LeoZ24/MAGNUS_Chess_Robot/README.md

# MAGNUS — Robot de Ajedrez Autónomo

> Proyecto de feria científica (PRONAFECYT 2026) construido por un estudiante de 16 años.
> Un robot que detecta el estado del tablero con visión artificial, calcula la mejor
> jugada con un motor de ajedrez y la ejecuta físicamente con un brazo articulado.

---

## Índice

1. [Arquitectura del sistema](#arquitectura-del-sistema)
2. [Hardware](#hardware)
3. [Software — módulos](#software--módulos)
4. [Especificaciones físicas críticas](#especificaciones-físicas-críticas)
5. [Estrategia de movimiento del brazo](#estrategia-de-movimiento-del-brazo)
6. [Sistema de localización con ArUco](#sistema-de-localización-con-aruco)
7. [Voz y comentarios](#voz-y-comentarios)
8. [Protocolo de mensajes entre módulos](#protocolo-de-mensajes-entre-módulos)
9. [Estado actual y hoja de ruta](#estado-actual-y-hoja-de-ruta)
10. [Instalación](#instalación)
11. [Ejecución rápida](#ejecución-rápida)
12. [Tests](#tests)
13. [Convenciones del proyecto](#convenciones-del-proyecto)

---

## Arquitectura del sistema

MAGNUS sigue una arquitectura modular inspirada en ROS2: nodos independientes que
se comunican mediante mensajes tipados. Cada nodo puede desarrollarse, testearse y
reemplazarse sin afectar a los demás.

```
┌─────────────────┐    PositionRequest(FEN)    ┌──────────────────┐    MoveResponse    ┌──────────────────────┐
│   NODO VISIÓN   │ ──────────────────────────▶│  NODO DEL ENGINE │ ──────────────────▶│  NODO DEL BRAZO      │
│  (ArUco/OpenCV) │                            │  (Stockfish/UCI) │                    │  (CyberPi / mBot2)   │
│                 │                            │                  │                    │                      │
│  Tablero físico │                            │  Calcula jugada  │                    │  Busca movimiento    │
│  → FEN string   │                            │  + metadatos     │                    │  pregrabado y lo     │
│                 │                            │                  │                    │  reproduce           │
└─────────────────┘                            └──────────────────┘                    └──────────────────────┘
       ▲                                                                                          │
  Cámara cenital                                                                          (V2 futuro) ▼
  (MacBook Air M1 /                                                                      Corrección por visión
   Raspberry Pi 4/5)                                                                      del marcador del brazo
```

### Módulos y estado

| Módulo | Ruta | Estado | Descripción |
|---|---|---|---|
| **Mensajes/Core** | `magnus/core/` | ✅ Completo | Contratos de datos entre nodos (PositionRequest, MoveResponse) |
| **Engine** | `magnus/engine/` | ✅ Completo | FEN → jugada con metadatos, via Stockfish UCI |
| **Visión** | `magnus/vision/` | ✅ Software completo | Detección → homografía → FEN exacta (turno/enroque por inferencia); falta validar con cámara/tablero reales |
| **Brazo robótico**| `magnus/arm/` | 🔶 En pruebas reales | Secuencias pregrabadas + `CyberPiBackend` (TCP sobre Wi-Fi) funcionando con el brazo real y tabla `positions.json` grabada; falta afinar la precisión |
| **Voz** | `magnus/voice/` | ✅ Software completo | El robot narra sus jugadas y comenta las del rival en español; falta elegir la voz definitiva de oído |
| **App de juego**  | `magnus/app/` + `play.py` | ✅ Completo | Une los cuatro nodos en una aplicación con panel de control web: partida en vivo, dificultad en caliente, ajustes y brazo (apagado / simulado / CyberPi) |

---

## Hardware

### Computación

| Dispositivo | Rol | Estado |
|---|---|---|
| MacBook Air M1 | Desarrollo y procesamiento visual | En uso |
| Raspberry Pi 4 o 5 | Computación embebida (producción) | Futuro |
| CyberPi (placa mBot2) | Control de motores/servos del brazo | En uso (TCP sobre Wi-Fi) |

### Cámara

- Montaje cenital (mirando hacia abajo sobre el tablero)
- Calibración de cámara **pendiente** (necesaria para la homografía de las
  esquinas del tablero y el rastreo del marcador del brazo)
- Se usa con OpenCV y el módulo `cv2.aruco`

### Tablero de ajedrez

- **Tamaño de casilla:** 32 mm × 32 mm
- **Área de juego total:** 256 mm × 256 mm (8×8 casillas)
- **Imanes en casillas:** cilíndrico 6×3 mm, uno por casilla, embutido en el
  centro — mantienen las piezas posicionadas
- **Marcadores ArUco en las 4 esquinas del tablero** (nuevo): permiten calcular
  la homografía tablero↔cámara, necesaria para la futura corrección de
  posición del brazo (ver [Sistema de localización con ArUco](#sistema-de-localización-con-aruco))
- Material: accesible / imprimible en 3D

### Piezas de ajedrez

- **Forma:** circular (tapa plana)
- **Diámetro:** 22.5 mm
- **Marcador ArUco:** integrado en la cara superior (diccionario `DICT_4X4_50`)
- **Anillo de contraste:** blanco, alrededor del marcador, para mejorar detección
- **Imán en pieza:** cilíndrico 10×2 mm, embutido en la base
- **Fabricación:** filamento PLA en BambuLab A1 mini

#### Asignación de IDs ArUco

Hay **tres roles distintos** de marcadores ArUco con rangos de ID separados,
definidos formalmente en `magnus/config.py`:

| Rol | Cantidad | IDs | Estado |
|---|---|---|---|
| Piezas de ajedrez | 12 tipos (32 piezas físicas) | `0–23` (con huecos) | ✅ mapeo oficial en `magnus/vision/piece_map.py` |
| Esquinas del tablero | 4 | `40–43` | ✅ 40=a8, 41=h8, 42=h1, 43=a1 |
| Marcador del brazo | 1 | `44` | ✅ reservado (rastreo V2) |

> **Mapeo ID→pieza oficial:** el marcador identifica el **tipo** de pieza
> (tipo + color), no la pieza individual — todos los peones blancos llevan el
> mismo marcador. La detección rastrea las instancias repetidas por posición.
>
> | Pieza   | Blancas | Negras | | Pieza | Blancas | Negras |
> |---------|---------|--------|-|-------|---------|--------|
> | Peón    | `0`     | `12`   | | Torre | `6`     | `18`   |
> | Caballo | `1`     | `15`   | | Dama  | `8`     | `21`   |
> | Alfil   | `2`     | `16`   | | Rey   | `9`     | `23`   |
>
> Los PNG imprimibles de los 17 marcadores (cada etiqueta indica cuántas copias
> imprimir) se generan con `python3 examples/generate_aruco_markers.py`.

### Brazo robótico — articulado, 2 grados de libertad + garra

| Actuador  | Articulación | Puerto | Función |
|---|---|---|---|
| Motor 1 | Hombro | `EM1`  | Primer eslabón (motor Encoder mBot2, transmisión directa) |
| Motor 2 | Codo | `EM2`  | Segundo eslabón (motor Encoder mBot2, transmisión directa) |
| Servo 3 | Garra/agarre | `S1` | Baja, levanta y suelta el imán N52 sobre la pieza |

- **Control:** CyberPi (placa del kit mBot2) con el cliente
  `examples/cyberpi_arm_client.py`, subido desde mBlock en modo UPLOAD
- **Sin reductores:** grado de motor = grado de eslabón en los dos ejes (se
  probó un 3:1 en el hombro y se descartó)
- **Sistema de agarre (confirmado):** imán N52 (12×3 mm) en el extremo del
  brazo. El servo `S1` tiene **tres posiciones**: `0°` baja el imán y agarra la
  pieza, `110°` la **levanta sin soltarla** (para no arrastrarla por el tablero)
  y `170°` la suelta. Hombro y codo no dan altura: la da este servo
- **Apoyo del hombro:** un geekservo en `M1` puede empujar a favor del hombro
  (`ASSIST_ENABLED`, desactivado por defecto)
- **Fabricación de partes estructurales:** PLA en BambuLab A1 mini
- **Comunicación Python ↔ CyberPi (confirmada):** TCP sobre Wi-Fi. El ordenador
  abre un servidor (`CyberPiBackend`, puerto 5555) y la CyberPi se conecta a él.
  Protocolo de líneas de texto: `PING` / `HOME` / `LIMITS` / `ZERO` / `MOVE` /
  `GRIPPER` / `GET` / `STOP`, cada una con su `ACK` o `ERR <mensaje>`
- **Referenciado (`HOME`):** los encoders son incrementales, así que al
  conectar cada eje se empuja contra un tope físico y se declara el cero ahí
  (primero el codo, luego el hombro). Por eso el hombro solo admite ángulos
  **positivos** y el codo solo **negativos**

> ⚠️ El cliente lleva `SSID` / `PASS` / `MAC_IP` como **marcadores**: los datos
> reales del Wi-Fi se escriben solo en mBlock antes de subirlo a la placa y
> nunca se copian al repositorio.

⚠️ **Cuidado con el imán N52:** es fuerte y su radio de influencia puede
desplazar piezas en casillas adyacentes si el brazo pasa muy cerca del tablero
en movimientos laterales. Ver [Estrategia de movimiento del brazo](#estrategia-de-movimiento-del-brazo).

---

## Software — módulos

### `magnus/core/` — Contratos de datos

Estructuras de datos puras sin dependencias de ajedrez. Cualquier nodo puede
importarlas sin arrastrar `python-chess`.

```python
# Petición al engine
PositionRequest(
    fen="rnbqkbnr/pppppppp/8/8/8/8/PPPPPPPP/RNBQKBNR w KQkq - 0 1",
    difficulty="MEDIUM",  # o None para usar la dificultad por defecto del nodo
    movetime=None,        # segundos máximos de cálculo (None = usar preset)
    request_id="move-001"
)

# Respuesta del engine (incluye metadatos para el brazo)
MoveResponse(
    uci="e2e4",           # origen→destino para el brazo
    san="e4",             # notación algebraica
    is_capture=False,
    captured_square=None, # casilla donde está la pieza capturada (≠ to_square en al paso)
    is_castling=False,
    rook_from=None,       # para enroque: el brazo debe mover también la torre
    rook_to=None,
    is_en_passant=False,  # captura al paso: la pieza capturada NO está en to_square
    promotion=None,       # "q", "r", "b", "n"
    is_check=False,
    is_checkmate=False,
    resulting_fen="...",  # FEN tras la jugada (para verificación con visión)
    ...
)
```

### `magnus/engine/` — Nodo del engine

Recibe una `PositionRequest` (FEN + dificultad), usa Stockfish via protocolo UCI
y devuelve una `MoveResponse` con todos los metadatos relevantes para el brazo.

**Niveles de dificultad (10):**

| Nivel | Elo aprox. | `movetime` | Cómo se debilita |
|---|---|---|---|
| `LEARNER`  | ~400 | 0.05 s | errores a propósito (85 %) |
| `NOVICE` | ~700 | 0.05 s | errores a propósito (70 %, pierde ≤ 900 cp) |
| `CASUAL` | ~950 | 0.05 s | errores a propósito (55 %, pierde ≤ 600 cp) |
| `AMATEUR`  | ~1150 | 0.05 s | errores a propósito (50 %, pierde ≤ 450 cp) |
| `BEGINNER` | ~1350 | 0.05 s | `Skill Level` 0 + `UCI_Elo` |
| `EASY` | ~1500 | 0.10 s | `Skill Level` 3 + `UCI_Elo` |
| `MEDIUM` | ~1800 | 0.20 s | `Skill Level` 8 + `UCI_Elo` (por defecto) |
| `HARD` | ~2200 | 0.50 s | `Skill Level` 14 + `UCI_Elo` |
| `EXPERT` | ~2600 | 1.00 s | `Skill Level` 18 + `UCI_Elo` |
| `MAXIMUM`  | máximo | 2.00 s | sin límite |

Stockfish no baja de ~1320 de Elo, así que los cuatro niveles más bajos se
debilitan **por software**: el backend pide varias jugadas candidatas
(`multipv`) y, con cierta probabilidad, elige una peor que la mejor sin perder
más de un tope de centipeones. En esos niveles el Elo es una etiqueta
aproximada. Los presets están en `magnus/engine/difficulty.py`.

El backend es intercambiable: cualquier motor UCI (Stockfish, Lc0, Komodo...)
funciona sin cambiar el resto del sistema.

### `magnus/vision/` — Nodo de visión

Tablero físico → placement → FEN exacta. Componentes:

- `aruco_detector.py` — detección con "enclavamiento" **multi-instancia**: un
  marcador debe verse N frames consecutivos antes de confirmarse, y como los
  IDs identifican el *tipo* de pieza (los 8 peones blancos comparten ID), cada
  instancia física se rastrea por posición; los tres roles de marcadores van
  separados.  Las esquinas, al ser estáticas y de ID único, **se recuerdan en
  su última posición** aunque una pieza las tape
- `board_pose.py` — homografía tablero(mm)↔imagen(px) con las 4 esquinas; mapea
  el centro de cada pieza a su casilla.  Deduce de la geometría qué esquina
  ocupa cada marcador (tolera marcadores cruzados y cualquier orientación de
  cámara) y descarta lo que esté fuera del área de juego
- `piece_map.py` — mapeo oficial ID ArUco → símbolo FEN (por tipo de pieza)
- `fen_builder.py` — placement → texto FEN (módulo puro)
- `game_state.py` — `GameTracker`: deduce la jugada del humano comparando el
  placement detectado contra las jugadas legales de la partida → turno,
  enroque y al paso exactos, sin hardware extra
- `calibration.py` — calibración de cámara (opcional en v1)
- `synthetic.py` — genera imágenes sintéticas del tablero (tests/demos sin cámara)
- `board_render.py` — representación 2D profesional del tablero (iconos de
  pieza, última jugada, flecha de la jugada planificada, jaque) + dashboard
  completo para el demo en vivo
- `vision_node.py` — `BoardVisionNode` con backend de cámara intercambiable
  (`OpenCVCameraBackend` real / `FakeCameraBackend` para tests)

```python
from magnus.vision import BoardVisionNode, OpenCVCameraBackend

with BoardVisionNode(camera=OpenCVCameraBackend(0)) as node:
    placement = node.get_board_placement()   # {"e4": "P", ...}
    fen = node.get_board_fen()               # FEN exacta tras la jugada del humano
```

**Pendiente:** validar con la cámara y el tablero físicos reales; rastreo del
marcador del brazo (V2).

### `magnus/arm/` — Nodo del brazo

Recibe una `MoveResponse` y reproduce los movimientos **pregrabados**
correspondientes. No calcula cinemática inversa.

- `backend.py` — `ArmBackend` (ABC) + `FakeArmBackend` (tests/demos, registra
  los comandos) + `CyberPiBackend` (servidor TCP al que se conecta la CyberPi;
  repite hasta 2 veces un `MOVE` que la placa rechaza con `ERR`)
- `positions_table.py` — carga/consulta de `positions.json` (64 casillas +
  zonas `discard`/`exchange` + reposo `park` opcional) e
  `inspect_positions_file()`, que dice sin lanzar excepciones si la tabla está
  completa
- `arm_node.py` — `ArmNode.plan()` genera la secuencia (testeable) y
  `.execute()` la reproduce:
  - Si `is_capture`: mueve primero la pieza capturada a la zona de descarte
  - Si `is_castling`: rey primero, luego torre (`rook_from`/`rook_to`)
  - Si `is_en_passant`: retira el peón de `captured_square` (≠ destino)
  - Si `promotion`: peón a descarte + pieza promovida desde la zona de intercambio
  - Activa/desactiva la garra (servo 3) en los momentos correctos
  - Al terminar, retira el brazo a `park` para no tapar el tablero a la cámara
  - Fuera del tablero (`discard`, `park`) pide menos precisión
    (`config.ARM_OFFBOARD_TOLERANCE_DEG`) para no perder tiempo afinando

```python
from magnus.arm import ArmNode, FakeArmBackend, make_fake_table

with ArmNode(backend=FakeArmBackend(), table=make_fake_table()) as arm:
    steps = arm.execute(resp)   # resp: MoveResponse del engine
```

**Pendiente:** medir el recorrido real de cada eje (`SHOULDER_TRAVEL_DEG` /
`ELBOW_TRAVEL_DEG`, ahora 300° provisionales) y comprobar `BACKLASH_DEG`.

---

## Especificaciones físicas críticas

Estas constantes son fundamentales para todos los módulos. Están centralizadas
en **`magnus/config.py`** (única fuente de verdad — no hardcodearlas en módulos).

```python
# Tablero
SQUARE_SIZE_MM       = 32.0    # lado de cada casilla en mm
BOARD_SQUARES        = 8       # 8×8
BOARD_SIZE_MM        = SQUARE_SIZE_MM * BOARD_SQUARES  # 256 mm

# Piezas
PIECE_DIAMETER_MM    = 22.5
PIECE_MAGNET_D_MM    = 10.0    # diámetro imán pieza
PIECE_MAGNET_H_MM    = 2.0     # altura imán pieza

# Tablero — imanes de casilla
SQUARE_MAGNET_D_MM   = 6.0
SQUARE_MAGNET_H_MM   = 3.0

# Brazo — imán de agarre
ARM_MAGNET_D_MM      = 12.0
ARM_MAGNET_H_MM      = 3.0
ARM_MAGNET_GRADE     = "N52"   # fuerte: puede influir en piezas adyacentes

# ArUco — rangos de ID por rol (oficiales)
ARUCO_DICT           = "DICT_4X4_50"
ARUCO_IDS_PIECES      = frozenset({0, 1, 2, 6, 8, 9, 12, 15, 16, 18, 21, 23})
                                       # 12 tipos de pieza (las copias comparten ID)
ARUCO_IDS_BOARD_CORNERS = (40, 41, 42, 43)  # esquinas del tablero
ARUCO_ID_ARM          = 44             # marcador en el extremo del brazo
DETECTION_CONFIRM_N   = 5              # detecciones consecutivas para confirmar presencia
DETECTION_MATCH_RADIUS_FACTOR = 1.5    # asociación espacial de IDs repetidos
DETECTION_FORGET_FRAMES = 20           # olvidar una pieza confirmada que ya no se ve
```

---

## Estrategia de movimiento del brazo

> Esta es la decisión de diseño más importante del proyecto: MAGNUS **no**
> calcula cinemática inversa en tiempo real. En su lugar usa un enfoque de
> **"enseñar y reproducir" (teach & playback)**.

### ¿Por qué no cinemática inversa?

Con solo 64 casillas fijas, no es necesario resolver la trigonometría de un
brazo de 2 eslabones en cada jugada. Es más simple, más confiable para una
primera versión, y suficiente para una feria científica:

1. **Una sola vez**, se determinan y registran los ángulos de hombro y codo
   necesarios para que el brazo llegue al centro de cada una de las 64 casillas
2. Esos valores se guardan en una **tabla de consulta** (lookup table)
3. Durante el juego, el nodo del brazo simplemente **busca** los valores
   pregrabados para la casilla de origen y de destino, y reproduce esa
   secuencia de movimiento — sin ningún cálculo geométrico en vivo

### Formato de la tabla (`magnus/arm/positions.json`)

Una posición de hombro y codo por casilla, en grados de motor desde `HOME`.
El brazo no tiene movimiento vertical: el servo **S1** recoge y suelta usando
los mismos dos ángulos para todas las piezas.

La plantilla vacía (`python3 examples/generate_positions_template.py`) usa:

```json
{
  "e4": {"shoulder": null, "elbow": null},
  "e5": {"shoulder": null, "elbow": null}
}
```

Sustituye los `null` por lecturas reales. Las tablas antiguas con
`approach`/`engage` siguen cargando; se usa **`engage`** como posición única.

Además de las 64 casillas, la tabla lleva las zonas `discard` (piezas
capturadas) y `exchange` (piezas de promoción), y opcionalmente **`park`**: una
pose de reposo **fuera del tablero** a la que el brazo se retira al terminar
cada jugada, para no estorbar al rival ni taparle el tablero a la cámara. Sin
`park` se juega igual, solo que el brazo se queda donde terminó.

Una jugada típica (`e2` → `e4`, sin captura):

```
mover a e2 → S1 agarra y levanta → mover a e4 → S1 suelta → mover a park
```

### Cómo grabar la tabla

Con el cliente en la CyberPi y `play.py` cerrado, el modo recomendado es
**`--jog`**: el brazo se mueve con sus propios motores y tú lo ajustas a pasos
hasta que la punta cae en la casilla. Se graba la **orden**, no la lectura del
encoder:

```bash
python3 examples/record_arm_positions.py --all --jog --write   # toda la tabla
python3 examples/record_arm_positions.py e4 d5 --jog --write   # solo algunas
python3 examples/record_arm_positions.py park --jog --write    # zona de reposo
```

> **Por qué no colocarlo a mano.** Con los motores sueltos el brazo no flexa
> igual que cuando lo empujan los motores: el mismo ángulo de encoder deja la
> punta en dos sitios distintos. Una tabla medida a mano se queda corta siempre
> en el mismo sentido y sin dar ningún error.

Teclas del modo `--jog`:

| Tecla | Qué hace |
|---|---|
| `h+5`, `c-3`, `h+2 c-1` | ajusta hombro / codo a pasos |
| `h=85` | fija un valor exacto |
| `Enter` | graba la casilla y pasa a la siguiente |
| `p` | prueba a recoger la pieza (agarra y levanta; `Enter` la suelta) |
| `v` | lleva el brazo a la orden desde lejos y por los dos lados, como al jugar |
| `r` | hace `HOME` otra vez (`--home-each` lo hace antes de cada destino) |
| `s` / `q` | salta la casilla / sale |

`--write` **fusiona** lo grabado en `magnus/arm/positions.json` (dejando una
copia `.bak`): grabar dos casillas no borra las demás. Sin `--write` solo
imprime el JSON. No apagues el shield ni reinicies la CyberPi entre lecturas:
perderías el cero.

Los tres ángulos de la garra (`GRIPPER_ENGAGE_ANGLE`, `GRIPPER_LIFT_ANGLE`,
`GRIPPER_RELEASE_ANGLE`) son comunes a todas las piezas y viven en el cliente
de la CyberPi; no se graban por casilla.

### Cómo se mueve cada eje (cliente CyberPi)

El control interno del motor encoder es de **velocidad**, no de par: a pocas
RPM no vence el peso del brazo. Por eso cada `MOVE` tiene dos fases:

1. **Tramo grueso** con `EM_turn`; si una pasada se queda corta, la siguiente
   va más rápida (más RPM = más par).
2. **Último tramo** con impulsos de potencia cruda que miden el ritmo real del
   eje y se acortan al acercarse, para llegar sin pasarse.

Otras defensas, todas en `examples/cyberpi_arm_client.py`:

- **Retención nativa** (`EM_lock`, `HOLD_ENABLED`): los ejes se sostienen
  entre movimientos. `STOP`, un fallo o una desconexión **liberan los
  motores**: sostén el brazo con la mano al pararlo.
- **El codo se mueve primero y el hombro al final**, porque el hombro es el
  que peor se sostiene. Al terminar se releen los dos encoders y se corrige el
  que haya cedido.
- **Compensación de juego** (`BACKLASH_DEG`, 3°): el último tramo entra
  siempre en el mismo sentido, así la tabla grabada a pasos cortos y la
  partida con giros largos llegan igual.
- **Presupuesto de tiempo:** un `MOVE` deja de afinar a los 15 s y responde
  con lo que haya; si lo rechaza, el ordenador lo repite (es absoluto, así que
  repetirlo lleva al mismo sitio).

**Cada cambio del cliente hay que volver a subirlo desde mBlock en modo
UPLOAD**: reiniciar `play.py` no actualiza la placa. Si aparece `EM_lock no
disponible`, actualiza el firmware de CyberPi/mBot2. Si la subida se queda
colgada en 1 %, para el programa en marcha, cierra el monitor serie, reinicia
la placa o prueba otro cable USB.

Con `play.py` cerrado y el espacio del brazo despejado, `python3 test_humo.py`
mide el error de cada eje, la deriva en reposo y el retorno a cero, e imprime
un diagnóstico. Si el brazo se queda corto, la causa número uno es la batería
del shield (los motores **no** se alimentan del USB).

### Corrección automática de posición (V2 — futuro, no implementar todavía)

Si los movimientos pregrabados resultan imprecisos (por ejemplo, por
deslizamiento mecánico o desgaste), el plan a futuro es:

1. Calcular la posición **esperada** del marcador del brazo en la imagen
   (usando la homografía de las 4 esquinas del tablero + la casilla objetivo)
2. Detectar la posición **real** del marcador del brazo con la cámara
3. Calcular el **offset** (error) entre la posición esperada y la real
4. Ajustar levemente los ángulos de motor antes de ejecutar el siguiente movimiento

Este flujo de corrección **no es parte de la v1** del proyecto, pero el
sistema de marcadores ArUco (esquinas + marcador del brazo) se está
incorporando desde ahora para tenerlo listo cuando se necesite.

---

## Sistema de localización con ArUco

Tres roles de marcadores, cada uno con su propio propósito:

| Marcador | Cantidad | Propósito |
|---|---|---|
| En cada pieza | 12–32 | Identificar tipo/color de pieza → construir la FEN |
| En las 4 esquinas del tablero | 4 | Calcular la homografía tablero↔cámara (pose del tablero) |
| En el extremo del brazo | 1 | Rastrear la posición real del brazo (para corrección V2) |

La homografía de las esquinas permite, en teoría, ubicar cualquier punto del
tablero en coordenadas de imagen y viceversa — esto es lo que hace posible,
a futuro, comparar "dónde debería estar el brazo" contra "dónde está
realmente" usando la cámara.

### Cómo colocar los 4 marcadores de esquina

Los IDs **recorren el borde del tablero**, no van en orden de lectura:

```
    40 (a8) ─────────── 41 (h8)          ✅ 40 → 41 → 42 → 43 recorre el
      │                    │                borde (sentido horario visto
    43 (a1) ─────────── 42 (h1)             desde arriba con blancas abajo)

    40 ─────── 41                        ❌ zig-zag: 42 y 43 cruzados
      │  ╳     │
    42 ─────── 43
```

El centro de cada marcador debe coincidir con la esquina exterior del área de
juego.  Puntos importantes del montaje:

- **La orientación de la cámara da igual**: cada esquina se identifica por su
  ID, así que la cámara puede estar apaisada, vertical, del lado de las blancas
  o de las negras, y el tablero girado cualquier ángulo dentro de la imagen.
- Si dos marcadores contiguos se colocan cruzados, la visión lo **detecta y lo
  corrige sola** (avisa en el dashboard) — antes esto producía una homografía
  degenerada en la que todas las piezas caían "fuera del tablero".
- Si el tablero digital sale girado 90/180°, se corrige con la tecla `T` del
  demo, o iniciando la partida con `G` desde la posición inicial (deduce la
  orientación probando los cuatro giros).
- Una esquina tapada por una pieza **no** rompe nada: la última posición
  conocida se recuerda mientras la cámara y el tablero no se muevan (tecla `R`
  para olvidarla si se mueven).

---

## Voz y comentarios

MAGNUS narra lo que hace y comenta cómo va la partida, en español:

> «Muevo el caballo de ge uno a efe tres.»
> «Capturo el peón en e cinco con el alfil desde ce cuatro. Jaque.»
> «Uy. Eso fue un error grave.» · «Buena jugada. Sigue así.»

### Cómo decide qué comentar

Se compara la evaluación **antes y después** de la jugada del rival, igual que
hacen Lichess o Chess.com:

```
Δ = eval_después − eval_antes        (siempre a favor del robot, en centipeones)

Δ ≥ +300  error grave      Δ ≤  −50  buena jugada
Δ ≥ +150  error            Δ ≤ −150  muy buena jugada
Δ ≥  +50  imprecisión      |Δ| < 50  normal → se calla
```

Los umbrales están en `magnus/config.py` (`COMMENT_*`) y son generosos a
propósito: es preferible callar que acusar de un error que no lo fue.

El análisis usa `ChessEngineNode.analyse_fen()`, que va a **fuerza fija**
(`ANALYSIS_CONFIG`, skill 20) y no a la dificultad de juego. Así el robot puede
jugar en `BEGINNER` para que le ganes y aun así **comentar como un maestro**.

### Motor de voz

| Backend | Cuándo | Notas |
|---|---|---|
| `PiperBackend` | **Recomendado** | Neuronal, local, gratis. Sin internet y con el mismo código en Mac y Raspberry Pi |
| `MacSayBackend` | Respaldo | El comando `say` de macOS, cero instalación |
| `FakeSpeechBackend` | Tests y silencio | No suena; registra lo que se habría dicho |

`default_backend()` elige el mejor disponible y, si no hay ninguno, devuelve el
falso: **quedarse sin voz nunca interrumpe una partida**.

> **En macOS el intérprete se llama `python3`, no `python`** (`python` a secas
> da `zsh: command not found`). Y si tienes varias versiones instaladas, usa
> siempre `python3.X -m pip install …` en vez de `pip install …`: así el paquete
> acaba en el mismo intérprete con el que ejecutas el proyecto. Ese desajuste es
> la causa número uno del `No module named 'piper'`.

```bash
# Comprueba con qué Python estás trabajando y que ahí está piper
python3 -c "import sys, piper; print(sys.executable, 'piper OK')"

# Voces del sistema (macOS): no hay que instalar nada
python3 examples/audition_voices.py --engine say        # audiciona las masculinas
python3 examples/audition_voices.py --engine say --all-spanish --list

# Piper (para la Raspberry Pi). OJO: instálalo en el MISMO Python con el que
# ejecutas el proyecto — tener varios Python es la causa nº 1 de
# "No module named 'piper'":
python3 -m pip install piper-tts          # OJO: python3 -m pip, no pip
python3 -m piper.download_voices es_MX-claude-high --data-dir voices/
python3 examples/audition_voices.py --engine piper --play
```

> **Los modelos de voz NO se suben a git.** Pesan entre 60 y 110 MB y GitHub
> rechaza cualquier archivo de más de 100 MB (`GH001: Large files detected`).
> La carpeta `voices/` está en `.gitignore`: cada quien descarga la voz que
> necesita. Si por accidente ya los commiteaste, sácalos con
> `git rm -r --cached voices` antes de volver a hacer push.
>
> **El sufijo del nombre es el nivel de calidad y se nota muchísimo.**
> `x_low` y `low` van a 16 kHz y suenan apagadas, "como debajo del agua";
> `medium` sube a 22 kHz; `high` es la única que suena natural. Usa siempre una
> voz `-high`. MAGNUS **no aplica ningún efecto de audio** a la voz (ni
> filtros, ni cambio de tono, ni resampleo): si suena rara, es el modelo.

La voz elegida se pone en `magnus/config.py` → `VOICE_MACOS_VOICE` (para `say`)
o `VOICE_PIPER_MODEL` (para Piper). También se puede probar sin editar nada:
`python3 examples/run_vision_demo.py --say-voice Jorge`.

MAGNUS habla en masculino, así que la voz por defecto de macOS es **Juan**
(es_MX); si no está instalada, el backend busca otra voz masculina en español
en vez de quedarse mudo.

### Qué más dice

Además de narrar y evaluar, el robot avisa cuando el tablero no cuadra, y
distingue **qué** está pasando en vez de soltar un genérico "no entiendo".
`VOICE_WARN_BOARD_PROBLEMS` elige de cuáles de estos avisa en voz alta:

| Situación detectada | Qué dice | ¿Por defecto? |
|---|---|---|
| Una pieza cambió de casilla pero la jugada no es legal | «Esa jugada no es legal. Devuelve la pieza a su sitio.» | ✅ sí |
| Falta una pieza, no hay ninguna nueva | «¿Tienes una pieza en la mano? Colócala cuando decidas.» | ❌ no |
| Demasiadas diferencias (mano encima, piezas caídas) | «Algo no cuadra en el tablero. Revísalo, por favor.» | ❌ no |
| El tablero vuelve a ser correcto | «Ahora sí. Seguimos.» | tras un aviso |

**Por qué solo la jugada ilegal.** Los otros dos avisos se apoyan en que una
pieza *desaparezca* del tablero, y con poca luz la detección parpadea: las
piezas se pierden un par de segundos y vuelven, así que saltaban en falso todo
el rato. Una jugada ilegal exige que la pieza reaparezca en **otra** casilla,
cosa que el parpadeo no produce — por eso este aviso sí aguanta con mala luz. Y
además es el único que le dice al rival algo que no sabe ya.

Los problemas silenciados tampoco disparan el «ahora sí, seguimos»: sería raro
oír el visto bueno de algo de lo que nunca se avisó.

El aviso **no se repite** mientras el problema siga igual: durante una jugada
larga saldría en bucle. La clasificación vive en `commentary.diagnose_placement()`
y es una función pura sobre dos diccionarios de casillas, así que se testea sin
cámara ni tablero.

Puede narrar también las jugadas del rival (`VOICE_ANNOUNCE_HUMAN_MOVES`,
desactivado por defecto: repetir en voz alta lo que el rival acaba de hacer
delante de él resulta redundante). Con el flag en `False` el robot sigue
reaccionando a las capturas y a los jaques, que sí aportan.

En todo caso recuerda con amabilidad que le toca si tarda mucho
(`VOICE_IDLE_PROMPT_S`), saluda, dice «te toca» tras mover y despide la
partida. Cada situación tiene entre 3 y 7 formulaciones distintas y nunca
repite la última usada.

### Detalles que importan

- **Nunca se le pasa notación cruda al TTS**: `"g1"` se convierte en `"ge uno"`
  y `"N"` en `"caballo"` (`speech_text.py`). Un TTS leyendo "Cxf3" es
  ininteligible.
- **Se habla en un hilo aparte**: sintetizar tarda ~1 s y la visión corre a
  ~14 fps; hablar en el bucle principal la congelaría.
- **Subtítulos en el dashboard**: la última frase aparece sobre la imagen de la
  cámara. En una feria ruidosa se lee aunque no se oiga. Tecla `M` para
  silenciar el audio manteniendo los subtítulos.
- **La voz es accesoria**: si el audio falla, se registra el error y la partida
  continúa en silencio.

---

## Protocolo de mensajes entre módulos

Los módulos se comunican con objetos Python pasados directamente (mismo proceso)
o serializados a JSON (procesos separados / red).

```python
# Serialización
req_dict  = request.to_dict()           # -> dict JSON-serializable
req_again = PositionRequest.from_dict(req_dict)  # tolera claves extra

resp_dict = response.to_dict()          # MoveResponse también tiene to_dict()
```

---

## Estado actual y hoja de ruta

### ✅ Completado

- Contratos de datos entre módulos (`magnus/core/`)
- Nodo del engine completo con 10 niveles de dificultad (`magnus/engine/`),
  los cuatro más bajos con errores a propósito
- Backend UCI intercambiable (Stockfish por defecto)
- Constantes físicas centralizadas (`magnus/config.py`)
- Módulo de visión completo (`magnus/vision/`): detección con enclavamiento,
  homografía de esquinas, mapeo ID→pieza, construcción de FEN completa
- Detección del turno/enroque/al paso por inferencia (`GameTracker`)
- Módulo del brazo (`magnus/arm/`): tabla de posiciones + planificador y
  reproductor de secuencias (captura, al paso, enroque, promoción)
- Zona de piezas capturadas y de intercambio (lógica; falta la física)
- Integración de los tres nodos, demostrada sin hardware
  (`examples/run_full_pipeline_demo.py`)
- Aplicación de juego con panel de control web (`play.py` + `magnus/app/`):
  partida en vivo, dificultad en caliente, ajustes persistentes, brazo en modo
  apagado / simulado / CyberPi
- Voz en español (`magnus/voice/`): narra, comenta la calidad de las jugadas y
  avisa de jugadas ilegales
- Comunicación con la CyberPi por TCP sobre Wi-Fi (`CyberPiBackend` + cliente
  `examples/cyberpi_arm_client.py`) con referenciado `HOME` contra topes
- Garra con imán N52 y tres posiciones del servo (agarrar, levantar, soltar)
- Tabla `positions.json` grabada con el brazo real (64 casillas + `discard` +
  `exchange` + `park`) y grabador `--jog` que mueve el brazo con sus motores
- Suite de tests completa (480+) con backends falsos — corre sin ningún hardware,
  incluido el cliente de la CyberPi con un shield simulado
- CI en GitHub Actions (tests en cada push/PR)
- Generador de marcadores ArUco imprimibles y de la plantilla de posiciones

### 🔶 En progreso / bloqueado por hardware

- Validar la visión con la cámara y el tablero físicos reales
- Calibración de la cámara real (el código ya existe: `magnus/vision/calibration.py`)
- Afinar la precisión del brazo: medir el recorrido real de cada eje y
  comprobar `BACKLASH_DEG` con la tecla `v` del modo `--jog`
- Probar el geekservo de apoyo del hombro (`ASSIST_ENABLED`, `ASSIST_SIGN`)
- Elegir la voz definitiva de oído (`examples/audition_voices.py`)

### 🔴 Pendiente (V2 / mejoras)

- Rastreo del marcador del brazo (`magnus/vision/arm_tracker.py`)
- Corrección automática de posición por visión (V2)
- Indicadores de estado en el propio robot (LEDs, pantalla CyberPi)
- Pasar a la Raspberry Pi como computadora del robot

---

## Instalación

```bash
# 1. Clonar el repositorio
git clone https://github.com/LeoZ24/MAGNUS_Chess_Robot.git
cd MAGNUS_Chess_Robot

# 2. Dependencias Python (en macOS: python3 -m pip, no pip a secas)
python3 -m pip install -r requirements.txt
python3 -m pip install -r requirements-dev.txt   # (opcional) pytest, para los tests

# 3. Motor de ajedrez (binario externo)
sudo apt install stockfish        # Linux / Raspberry Pi
brew install stockfish            # macOS

# O definir ruta manualmente:
export MAGNUS_ENGINE_PATH=/ruta/a/tu/motor_uci
```

### Dependencias

```
chess>=1.10                     # python-chess: FEN, reglas, protocolo UCI
opencv-contrib-python>=4.7      # cv2 + cv2.aruco (visión)
numpy>=1.23
piper-tts>=1.6                  # voz neuronal local (OPCIONAL: sin esto juega en silencio
                                # o con la voz `say` de macOS)
```

---

## Ejecución rápida

### Jugar (interfaz web) — el script final

`play.py` arranca el robot completo (visión + engine + voz + brazo) y abre el
**panel de control** en el navegador. Todo se maneja desde ahí: iniciar la
partida, cambiar la dificultad a mitad de partida, elegir el color del robot,
la cámara, la voz y el modo del brazo. No necesita ninguna dependencia nueva
(el servidor usa la librería estándar de Python).

```bash
python3 play.py                       # webcam 0; abre http://localhost:8080
python3 play.py --camera 1            # otra cámara (Iriun, OBS...)
python3 play.py --synthetic           # sin cámara: tablero simulado que juega solo
python3 play.py --list-cameras        # ¿qué índice da imagen?
python3 play.py --host 0.0.0.0        # controlar también desde una tablet/móvil del hotspot
python3 play.py --kiosk               # pantalla completa sin ajustes (feria)
python3 play.py --no-engine --no-voice
python3 play.py --arm cyberpi --arm-auto   # brazo real con ejecución automática
python3 play.py --arm cyberpi --arm-manual # ejecutar cada jugada con el botón
```

Lo que se ve en pantalla:

- **Pilotos de estado** (cámara, visión, engine, brazo, voz) en la barra superior.
- **Cámara en vivo** con los marcadores por rol, la cuadrícula proyectada y la
  jugada planificada; telemetría de detección y FEN.
- **Tablero digital animado**: las piezas se deslizan, la jugada que MAGNUS va a
  jugar late como flecha, el jaque brilla y las casillas con detección pendiente
  parpadean. Barra de evaluación al lado.
- **Banner de fase**: preparación (piezas detectadas 27/32) → *tu turno* →
  *MAGNUS piensa* → *MAGNUS juega e4* → *brazo en movimiento* → fin de partida.
- **Lista de jugadas, capturas, registro de actividad** y **subtítulo de la voz**.
- **Ajustes** (engranaje o tecla `S`): dificultad (10 niveles con Elo), color,
  cámara (girar mapeo, reiniciar detección), voz y brazo. Se guardan en
  `magnus_settings.json` y se recuperan al arrancar.

Atajos: `G` iniciar partida · `O` observar · `E` ejecutar brazo · `Esc` parada ·
`F` girar vista · `T` girar mapeo · `R` reiniciar detección · `M` voz ·
`S` ajustes · `K` pantalla completa.

**El brazo** tiene tres modos seleccionables en Ajustes:

| Modo | Qué hace | Requisitos |
|---|---|---|
| Apagado | MAGNUS canta la jugada y el humano mueve la pieza por él | ninguno |
| Simulado | Muestra la secuencia exacta que ejecutaría el brazo, paso a paso, con backend falso | ninguno |
| CyberPi | Ejecuta de verdad por TCP (`CyberPiBackend`) | `magnus/arm/positions.json` **completo** (64 casillas + `discard` + `exchange`; `park` opcional) |

Para jugar con el brazo real: cierra el script de calibración, enciende la
CyberPi con el cliente subido y ejecuta `python3 play.py` desde la carpeta del
proyecto. La terminal muestra la IP y el puerto TCP del host. Al conectar, el
brazo se referencia solo (`HOME`, ajuste `arm_auto_home`; también hay un botón
**Referenciar**). Coloca el tablero inicial y pulsa **Iniciar partida**.

- **Ejecución automática** por defecto: el brazo hace cada jugada solo. El
  selector «Automático / Con botón» del panel del brazo lo cambia.
- **La jugada del brazo cuenta al soltar la última pieza**, sin esperar a la
  cámara (que el propio brazo tapa); mientras tanto el tablero de la pantalla
  sigue al brazo pieza a pieza. Si la pieza no quedó bien, el brazo no vuelve a
  arrancar hasta que la cámara ve el tablero como debe estar.
- **PARADA** (`Esc`) o un fallo **no apagan** el modo automático: solo esa
  jugada queda en pausa esperando **Ejecutar**; la siguiente vuelve a ser
  automática.

`--synthetic` usa el brazo simulado aunque los ajustes guardados indiquen CyberPi;
para combinar tablero simulado y brazo real hay que indicar `--arm cyberpi`.

### Engine solo (sin hardware)

```bash
# Jugada desde la posición inicial, dificultad media
python3 examples/run_engine_node.py

# Posición concreta + dificultad máxima, salida JSON
python3 examples/run_engine_node.py \
    --fen "r1bqkbnr/pppp1ppp/2n5/4p3/4P3/5N2/PPPP1PPP/RNBQKB1R w KQkq - 2 3" \
    --difficulty MAXIMUM --json

# Engine contra sí mismo (6 medias-jugadas)
python3 examples/run_engine_node.py --selfplay 6 --difficulty EASY
```

### Pipeline completo simulado (sin cámara, sin brazo, sin tablero)

Integra los TRES nodos: se renderiza una imagen sintética del tablero con
marcadores ArUco reales, la visión la procesa y deduce la jugada del "humano",
el engine responde y el brazo (falso) imprime su secuencia de comandos:

```bash
python3 examples/run_full_pipeline_demo.py
python3 examples/run_full_pipeline_demo.py --plies 8 --difficulty EASY -v
```

### Brazo solo (sin hardware)

El engine calcula jugadas y se muestra la secuencia exacta de comandos que
recibiría el brazo real (backend falso + tabla de posiciones falsa):

```bash
python3 examples/run_arm_demo.py                    # una jugada
python3 examples/run_arm_demo.py --selfplay 6       # auto-partida con secuencias
```

### Visión en vivo (dashboard)

Sucesor del prototipo `ArUco_Test.py`: una sola ventana con la cámara (marcadores
por rol + cuadrícula proyectada), la **representación 2D del tablero** con iconos
de pieza, la última jugada, la **jugada que el robot va a jugar** (flecha, con
Stockfish), historial, capturas y FEN. Detecta todas las instancias de cada
marcador a la vez (los peones comparten ID).

```bash
python3 examples/run_vision_demo.py                 # webcam + Stockfish si está
python3 examples/run_vision_demo.py --list-cameras  # ¿qué índice da imagen?
python3 examples/run_vision_demo.py --camera 1      # cámara virtual (Iriun, OBS...)
python3 examples/run_vision_demo.py --synthetic     # sin cámara: partida simulada
python3 examples/run_vision_demo.py --no-engine     # sin Stockfish
python3 examples/run_vision_demo.py --icons assets/pieces   # PNGs propios (wP.png...)
# G inicia la partida (posición inicial; corrige la orientación sola),
# O observa, F gira la vista, T gira 90° el mapeo de casillas,
# R resetea la memoria de detección, Q sale
```

La cámara puede estar en cualquier orientación. El dashboard avisa si los
marcadores de esquina están cruzados (los corrige solo), marca con `MEM` las
esquinas tapadas que se están recordando y cuenta con `FUERA n` los marcadores
detectados fuera del tablero.

#### La cámara no da imagen (`No se pudo leer un frame de la cámara`)

Abrir el dispositivo **no** garantiza que esté transmitiendo, sobre todo con
cámaras virtuales (Iriun, EpocCam, OBS): el backend espera unos segundos al
primer frame (`--camera-warmup`) y tolera frames sueltos perdidos por wifi. Si
aun así no hay imagen:

1. **Permisos**: macOS → Ajustes → Privacidad y seguridad → Cámara, activa la
   app desde la que ejecutas (Terminal, VS Code…) y **reiníciala**. Este es el
   motivo de que "reiniciando VS Code a veces se arreglaba".
2. **Cámara virtual**: el móvil tiene que estar conectado y transmitiendo
   *antes* de arrancar el demo.
3. **Ocupada por otro programa** (Zoom, Photo Booth, otra instancia del demo).
4. **Índice equivocado**: con cámara integrada + Iriun, la buena no suele ser
   la `0`. `python3 examples/run_vision_demo.py --list-cameras` lista las que
   dan imagen de verdad.

### Voz

```bash
# Descargar una voz (una vez, con internet) y audicionar varias
python3 -m piper.download_voices es_ES-davefx-medium --data-dir voices/
python3 examples/audition_voices.py --play

# El demo habla solo; para silenciarlo:
python3 examples/run_vision_demo.py --muted      # subtítulos sí, audio no
python3 examples/run_vision_demo.py --no-voice   # ni voz ni subtítulos
```

### Utilidades

```bash
# PNGs de los 17 marcadores ArUco listos para imprimir (12 tipos de pieza,
# con las copias a imprimir en la etiqueta + 4 esquinas + brazo)
python3 examples/generate_aruco_markers.py

# Plantilla de positions.json para calibrar el brazo (valores en null)
python3 examples/generate_positions_template.py

# Grabar posiciones del brazo moviéndolo con sus motores (ver "Cómo grabar la tabla")
python3 examples/record_arm_positions.py --all --jog --write

# Prueba de humo y diagnóstico de los motores del brazo real
python3 test_humo.py
```

---

## Tests

```bash
pip install -r requirements-dev.txt
pytest tests/                   # los tests de integración se omiten sin Stockfish

pytest tests/ -v                # salida detallada
pytest tests/ -k "capture"      # solo tests de capturas
```

Ningún test necesita hardware: el engine usa `FakeBackend`, el brazo usa
`FakeArmBackend` + tabla falsa (valores 9999.x), la visión usa imágenes
sintéticas con marcadores ArUco reales inyectadas por `FakeCameraBackend`, y
el cliente de la CyberPi se importa con un `cyberpi` falso y un shield simulado
que se queda corto, cede y pierde la retención (`tests/test_cyberpi_arm_client.py`).
Los tests de integración con Stockfish se marcan con
`@pytest.mark.skipif(not _engine_available(), ...)`. La suite corre también en
CI (GitHub Actions) en cada push y pull request.

---

## Convenciones del proyecto

### Código

- **Idioma de comentarios y docstrings:** español
- **Nombres de variables y funciones:** snake_case en inglés (convención Python estándar)
- **Nombres de módulos:** inglés
- **Type hints:** obligatorios en todas las funciones públicas
- **Dataclasses** para mensajes entre módulos (no dicts crudos)
- **Logging** via `logging.getLogger("magnus.<módulo>")` — no `print()` en módulos

### Estructura de directorios

```
magnus/
├── core/
│   ├── __init__.py
│   └── messages.py          # PositionRequest, MoveResponse
├── engine/
│   ├── __init__.py
│   ├── backend.py           # EngineBackend (ABC) + UCIEngineBackend
│   ├── chess_engine_node.py # ChessEngineNode (servicio principal)
│   └── difficulty.py        # DifficultyLevel, EngineConfig, presets
├── config.py                # ✅ constantes físicas + rangos de ID ArUco
├── vision/                  # ✅ implementado
│   ├── __init__.py
│   ├── aruco_detector.py    # detección + enclavamiento multi-instancia (3 roles)
│   ├── calibration.py       # corrección de distorsión de cámara
│   ├── board_pose.py        # homografía a partir de las 4 esquinas ArUco
│   ├── piece_map.py         # mapeo oficial ID ArUco → símbolo FEN
│   ├── fen_builder.py       # placement → texto FEN
│   ├── game_state.py        # GameTracker (inferencia de jugadas)
│   ├── synthetic.py         # imágenes sintéticas para tests/demos
│   ├── board_render.py      # tablero 2D con iconos + dashboard del demo
│   └── vision_node.py       # BoardVisionNode + backends de cámara
├── voice/                   # ✅ narración y comentarios en español
│   ├── backend.py           # SpeechBackend (ABC) + Piper + macOS say + Fake
│   ├── speech_text.py       # "g1" -> "ge uno"; MoveResponse -> narración
│   ├── phrases.py           # frases con variantes (no repite la última)
│   ├── commentary.py        # Δ centipeones -> "error grave" / "buena jugada"
│   └── voice_node.py        # VoiceNode: cola + hilo propio
├── arm/                     # 🔶 funcionando con el brazo real; afinando precisión
│   ├── __init__.py
│   ├── backend.py           # ArmBackend (ABC) + FakeArmBackend + CyberPiBackend (TCP)
│   ├── positions_table.py   # carga/consulta de positions.json + inspect_positions_file()
│   ├── arm_node.py          # MoveResponse → secuencia de movimientos
│   └── positions.json       # tabla grabada con el brazo real
└── app/                     # ✅ aplicación de juego (interfaz web)
    ├── session.py           # GameSession + EngineWorker + SyntheticCamera
    ├── settings.py          # AppSettings <-> magnus_settings.json
    ├── arm_bridge.py        # ArmSupervisor: off / simulated / cyberpi
    ├── controller.py        # MagnusController: bucle de visión + cola de comandos
    ├── server.py            # HTTP (stdlib): página, SSE de estado, cámara, comandos
    ├── overlays.py          # dibujo sobre la imagen de la cámara
    └── static/              # index.html + app.css + app.js (sin frameworks)
play.py                      # ⭐ punto de entrada para jugar
test_humo.py                 # prueba de humo de los motores del brazo real
examples/                    # demos + cyberpi_arm_client.py (código de la placa)
tests/                       # 480+ tests, todos sin hardware
```

### Patrones de diseño

`magnus/arm/` y `magnus/vision/` siguen el mismo patrón que `magnus/engine/`:
- Un nodo principal (`ArmNode`) que recibe el mensaje de alto nivel
- Un backend intercambiable (`ArmBackend` ABC + `CyberPiBackend` implementación)
- Separación entre la lógica de la secuencia de movimiento y la comunicación con el hardware
- **Sin cálculo de cinemática inversa** — toda posición viene de `positions.json`

---

## Contexto del proyecto

MAGNUS fue desarrollado para el **PRONAFECYT 2026** (Programa Nacional de Ferias
de Ciencia, Tecnología e Innovación de Costa Rica), en la categoría de
**Investigación y Desarrollo Tecnológico**.

El sistema integra visión artificial, inteligencia artificial (motor de ajedrez)
y robótica en un proyecto de bajo costo construido con componentes accesibles e
impresión 3D.
