LeoZ24/MAGNUS_Chess_Robot/Assets/3d_Models/Gear adapter-1.stl

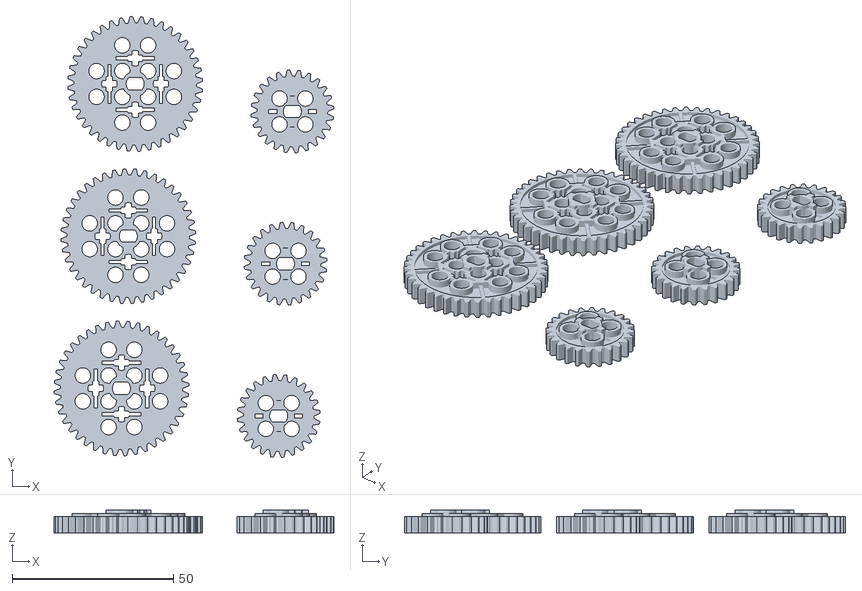
[picture p1: CAD file, 2026-06-13]
Assets/3d_Models/Gear adapter-1.stl
86.9 x 136.9 x 7.05
