LeoZ24/MAGNUS_Chess_Robot/Assets/3d_Models/Base del tablero-3.stl

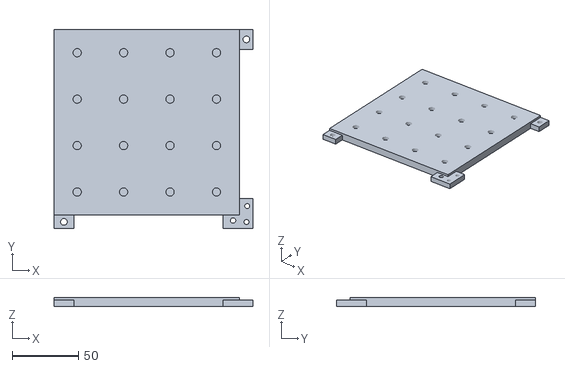
[picture p2: CAD file, 2026-06-13]
Assets/3d_Models/Base del tablero-3.stl
150.0 x 150.0 x 7.00
