LeoZ24/MAGNUS_Chess_Robot/examples/cyberpi_arm_client.py

# cyberpi_arm_client.py — Cliente del brazo MAGNUS (lado CyberPi, PRODUCCION)
# ===========================================================================
# Pegar en el editor Python de mBlock (modo UPLOAD) y subir a la CyberPi.
# Corre en MicroPython SIN sobrescribir el firmware.
#
# Este archivo vive en el repositorio SOLO para tenerlo versionado y poder
# revisarlo junto con el resto del codigo: la CyberPi no lo importa desde aqui.
# Si lo editas en mBlock, copia el resultado de vuelta a este archivo.
#
# ARQUITECTURA: la CyberPi es CLIENTE. Se conecta al host (Mac/Pi) que corre
# el servidor (CyberPiBackend). Asi nunca necesitamos la IP de la CyberPi.
# Si el socket se cae, la CyberPi reintenta conectarse sola.
#
# PROTOCOLO (lineas de texto terminadas en \n):
#   Host -> CyberPi                 CyberPi -> Host
#   ---------------------------     -----------------------------------
#   PING                            ACK PONG
#   HOME                            ACK HOME <hombro> <codo>
#   ZERO                            ACK ZERO       (pose actual = 0,0)
#   LIMITS                          ACK LIMITS <sh_lo> <sh_hi> <el_lo> <el_hi>
#   MOVE <hombro> <codo> [tol]      ACK MOVE <hombro> <codo>  (logrados)
#                                   tol: error aceptable (fuera del tablero)
#   GRIPPER <0|1>                   ACK GRIPPER    (1=agarra y LEVANTA, 0=suelta)
#   GET                             ACK POS <hombro> <codo>
#   STOP                            ACK STOP
#   (invalido / fallo)              ERR <mensaje>
#
# UNIDADES: grados de MOTOR (lo que lee el encoder), NO del eslabon. Ambas
# articulaciones son de transmision DIRECTA (no hay reductor en ninguna), asi
# que grado de motor = grado de eslabon. positions.json se graba directamente
# en grados de motor. Cero conversiones = cero bugs.

import cyberpi
import time
import usocket

# ======================= CONFIGURACION =======================

# ⚠️ ESTE ARCHIVO ESTA EN UN REPOSITORIO PUBLICO: no pongas aqui la clave de
# verdad de tu red. Rellena estos tres valores EN MBLOCK, justo antes de subir
# el programa a la placa, y deja los marcadores al copiar el archivo de vuelta.
SSID   = "TU_RED_WIFI"       # hotspot de 2.4 GHz (la CyberPi no ve 5 GHz)
PASS   = "TU_CLAVE_WIFI"     # NO la subas al repositorio
MAC_IP = "0.0.0.0"           # IP que imprime el CyberPiBackend al arrancar
PORT   = 5555

# --- Hardware (confirmado) ---
SHOULDER_PORT = "EM1"     # motor encoder del hombro (transmision directa)
ELBOW_PORT    = "EM2"     # motor encoder del codo   (transmision directa)
GRIPPER_PORT  = "S1"      # servo que acerca/aleja el iman N52

# --- Movimiento ---
# El control interno del motor encoder es de VELOCIDAD, no de par: a pocas RPM
# el PWM que aplica no vence el peso del brazo ni la friccion. El motor
# "quiere" moverse, no puede, y EM_turn devuelve el control con el eje a medio
# camino. Por eso cada movimiento tiene DOS FASES:
#
#   1. TRAMO GRUESO (_drive_turns): EM_turn, que tiene rampa y va suave. Si una
#      pasada cubre menos de MOVE_PROGRESS_RATIO de lo que se le pidio, la
#      siguiente va MAS RAPIDA (mas RPM pedidas = mas PWM = mas par).
#   2. ULTIMO TRAMO (_creep_to): impulsos de POTENCIA cruda, la misma tecnica
#      con la que HOME empuja contra el tope. La potencia da par aunque falte
#      medio grado; como no sabe frenar sola, va en impulsos cortos leyendo el
#      encoder entre uno y otro.
#
# Lo que NO hay que hacer (y es lo que estaba): bajar la velocidad al acercarse
# al objetivo. Dejaba el hombro clavado a 15 grados del destino (c7 -> c5 se
# quedaba en 35 de los 50 pedidos). Tampoco sirve un tope por eje tipo
# "el hombro siempre a 60": la escalada lo cubre con evidencia y sin adivinar.
MOVE_SPEED_RPM      = 60      # velocidad de la pasada gruesa (los dos ejes)
MOVE_SPEED_STEP_RPM = 30      # cuanto sube si una pasada se queda corta
MOVE_SPEED_MAX_RPM  = 120     # techo de esa escalada
MOVE_SPEED_FINE_RPM = 40      # tramos sin carga (retrocesos del referenciado)
TOLERANCE_DEG       = 1.0     # objetivo alcanzado si el error es menor
MOVE_MAX_PASSES     = 4       # pasadas gruesas antes de pasar a los impulsos
MOVE_PROGRESS_RATIO = 0.6     # fraccion del tramo pedido que una pasada debe
                              # cubrir para darla por buena. OJO: el criterio es
                              # QUEDARSE CORTO, no "no moverse": el eje avanzaba
                              # un cuarto del camino, asi que "no se movio nada"
                              # no lo detectaba nunca y la velocidad no subia.
MOVE_FAIL_DEG       = 3.0     # error final que se considera fallo -> ERR
MOVE_SETTLE_S       = 0.15    # dejar que el encoder se asiente entre pasadas
MOVE_SAG_DEG        = 1.5     # cuanto puede ceder un eje mientras se mueve el
                              # otro antes de volver a corregirlo. Con 2 un
                              # hombro que cedia 1.9 se daba por bueno; con 1
                              # (= TOLERANCE_DEG) cualquier temblor de encoder
                              # disparaba otro repaso y el brazo no paraba.
MOVE_SAG_PASSES     = 2       # repasos como maximo (corregir un eje puede
                              # mover un poco el otro)

# Tiempo maximo que un MOVE puede pasar AFINANDO. Pasado esto se deja de
# corregir y se responde con lo que haya (ACK si esta dentro de MOVE_FAIL_DEG,
# ERR si no). Tiene que ser bastante menor que el timeout del host
# (CyberPiBackend.command_timeout, 45 s): antes el brazo podia quedarse
# ajustando adelante y atras hasta que el host cortaba a los 20 s.
MOVE_BUDGET_S       = 15.0

# --- Impulsos de potencia del ultimo tramo ---
# La potencia cruda da par pero no sabe frenar: si el impulso dura de mas, el
# eje se pasa. Como no sabemos a que velocidad gira este brazo a una potencia
# dada (depende de la pose, del peso y de la bateria), NO se fija la duracion a
# ojo: se MIDE. Cada impulso deja un ritmo en grados/segundo y el siguiente dura
# lo justo para cubrir CREEP_AIM de lo que falta. Apuntar a menos del 100% es lo
# que hace que el eje se acerque sin cruzar el objetivo.
#
# Si el brazo se queda corto al final, sube CREEP_POWER_MAX; si se pasa de
# largo, baja CREEP_AIM o CREEP_PULSE_MIN_S.
CREEP_POWER         = 18      # % de potencia del primer impulso
CREEP_POWER_STEP    = 6       # subida cuando un impulso no mueve el eje
CREEP_POWER_MAX     = 55      # techo de potencia de los impulsos (40 no
                              # devolvia el hombro con el brazo desplegado)
CREEP_POWER_MIN     = 10      # suelo: por debajo el motor ya no mueve nada
CREEP_AIM           = 0.6     # a que fraccion de lo que falta apunta el impulso
CREEP_PULSE_MIN_S   = 0.05    # impulso mas corto (y el que mide el ritmo)
CREEP_PULSE_MAX_S   = 0.20    # nunca empujar mas de esto sin volver a mirar
CREEP_REST_S        = 0.06    # pausa para que el encoder se asiente
CREEP_MIN_DELTA_DEG = 0.3     # impulso que mueve menos que esto = falta par
CREEP_MAX_PULSES    = 20      # cota dura: nunca un bucle sin salida
CREEP_MAX_FLIPS     = 2       # veces que puede cruzar el objetivo antes de
                              # dejarlo. Con 4 el eje oscilaba alrededor de la
                              # casilla: cruzar dos veces ya dice que mas
                              # impulsos no lo van a clavar.

# Retencion nativa del shield: sostiene los ejes entre movimientos, incluso
# mientras el host piensa o mueve la garra. No necesita un bucle de correccion.
# STOP, un fallo o una desconexion liberan los motores: sostener el brazo.
HOLD_ENABLED       = True

# Orden de los ejes dentro de un MOVE: el CODO primero y el HOMBRO al final.
#
# Antes era al reves (se veia mejor: el brazo giraba y luego se desplegaba),
# pero en el brazo real el hombro NO aguanta el giro del codo: llegaba a 59,
# el codo daba 215 grados, y el hombro acababa en 52 sin poder volver
# ("ERR hombro no mantuvo"). Mover un eje empuja al otro (reaccion del motor y
# carga del brazo desplegado), asi que el eje que peor se sostiene va el
# ULTIMO: despues de el ya no se mueve nada que lo pueda desplazar.
#
# Con la pieza levantada (GRIPPER_LIFT_ANGLE) desplegar antes de girar ya no
# arrastra nada por el tablero.
MOVE_SHOULDER_FIRST = False

# --- Ayuda del hombro con el geekservo (OPCIONAL, desactivada) ---
# En el hombro hay un segundo actuador: un geekservo rojo que esta puesto para
# sostener el brazo, como un rodamiento. El problema es que un motor con
# reductora SIN alimentar no es un rodamiento: FRENA. Todo lo que el brazo
# flexiona y todo el par que le falta al motor encoder salen en parte de ahi.
#
# Con esto activado, el geekservo empuja en el MISMO sentido que el hombro
# mientras dura el tramo grueso, asi que deja de restar y pasa a sumar.
#
# Puerto y tipo ya CONFIRMADOS con el montaje real: geekservo de 2 cables en
# M1. Lo unico que queda por comprobar en el brazo es ASSIST_SIGN.
#
# ⚠️ COMO ACTIVARLO SIN ROMPER NADA:
#   1. Pon ASSIST_ENABLED = True y sube el cliente.
#   2. Manda UN solo movimiento de hombro, con la mano cerca del interruptor.
#   3. Si el hombro va MEJOR que antes, el signo es el bueno. Si pelea, vibra o
#      va peor, cambia ASSIST_SIGN a -1. No hay tercera opcion.
#   4. Con el signo bien, sube ASSIST_POWER poco a poco.
# Con el signo invertido los dos actuadores empujan en sentidos contrarios y se
# calientan sin mover el brazo: no lo dejes asi "a ver si mejora".
ASSIST_ENABLED = False    # <- lo unico que hay que cambiar para probarlo
ASSIST_PORT    = "M1"     # CONFIRMADO: geekservo de 2 cables en M1
ASSIST_KIND    = "dc"     # CONFIRMADO: 2 cables = puerto de motor
ASSIST_POWER   = 35       # % de empuje (empieza bajo y sube)
ASSIST_SIGN    = 1        # +1 o -1: sentido en el que AYUDA al hombro (ver arriba)

# Juego de la transmision (backlash). La reductora INTERNA del motor encoder
# tiene holgura, y el encoder no la ve: el mismo angulo de encoder deja la punta
# en dos sitios segun se llegue desde un lado o desde el otro. Con esto activo,
# el ultimo tramo entra SIEMPRE en el mismo sentido (*_APPROACH_SIGN): si el eje
# viene del lado contrario, primero se pasa BACKLASH_DEG y luego vuelve.
#
# Importa el doble porque la tabla se graba con pasos pequenos (--jog) y se
# juega con giros largos desde cualquier casilla: sin entrada unidireccional,
# grabacion y partida llegan cada una por su lado y no coinciden.
#
# Tiene que ser MAYOR que el juego real. Para medirlo, la tecla `v` de
# `record_arm_positions.py --jog` lleva el brazo a la misma orden desde los dos
# lados. 0 = desactivado.
BACKLASH_DEG  = 3.0
# Sentido del ultimo tramo, POR EJE: el mismo en que empuja la carga.
#
# En el brazo real el hombro se va SOLO hacia atras (59 -> 52, 52 -> 47) sin que
# nada mas se mueva: hay una carga fija que lo empuja hacia negativo. Si llega
# empujando CONTRA esa carga (subiendo), al parar el motor la holgura de la
# reductora cede hacia el lado de la carga y el eje cae. Si llega A FAVOR
# (bajando), los engranajes ya estan apoyados del lado de la carga y no hay
# holgura que ceder. Por eso el hombro entra desde arriba (-1).
SHOULDER_APPROACH_SIGN = -1   # el hombro entra BAJANDO (a favor de su carga)
ELBOW_APPROACH_SIGN    = 1    # el codo entra subiendo

# --- Limites de seguridad (grados de MOTOR) ---
# ⚠️ REGLA QUE CUESTA UN BRAZO SI SE OLVIDA: al referenciar, el cero queda EN
# el tope, asi que TODO el recorrido util esta del lado CONTRARIO al sentido
# de busqueda. Si un eje busca su tope en sentido positivo, sus angulos validos
# son NEGATIVOS, y mandarle +30 lo empuja contra el tope.
#
# Por eso los limites NO se escriben a mano: se derivan del sentido de
# referenciado, para que no se puedan contradecir. Lo unico que hay que medir
# es cuanto recorrido tiene cada eje desde su tope.
SHOULDER_TRAVEL_DEG = 300.0   # recorrido util del hombro desde su tope
ELBOW_TRAVEL_DEG    = 300.0   # recorrido util del codo desde su tope


def _limits_from_home(home_sign, travel):
    """Rango valido de un eje: del cero hacia el lado opuesto al tope."""
    if home_sign < 0:            # busca en negativo -> se trabaja en positivo
        return (0.0, travel)
    return (-travel, 0.0)        # busca en positivo -> se trabaja en negativo

# --- Referenciado automatico (HOME) ---
# Los motores encoder NO tienen cero absoluto: el contador arranca en 0 alla
# donde este el brazo al encender. Para que positions.json signifique siempre
# lo mismo, al arrancar se busca un TOPE FISICO fijo al chasis y se declara
# cero ahi. Es el mismo procedimiento de una impresora 3D o un brazo
# industrial sin encoder absoluto.
#
# Sin topes montados todavia: pon HOMING_ENABLED = False y usa ZERO a mano.
HOMING_ENABLED     = True
HOME_POWER         = 30       # % de potencia de la pasada de busqueda
HOME_POWER_FINE    = 18       # % de la segunda pasada (mas precisa y suave)
HOME_SHOULDER_SIGN = -1       # sentido hacia el tope del hombro (calibrado)
HOME_ELBOW_SIGN    = 1        # sentido hacia el tope del codo  (calibrado)
HOME_SAMPLE_S      = 0.12     # periodo de muestreo del encoder
HOME_STILL_N       = 3        # muestras quietas seguidas = tope tocado
HOME_MIN_DELTA_DEG = 0.8      # menos que esto entre muestras = quieto
HOME_START_GRACE_S = 1.0      # arranque: no declarar tope antes de esto
HOME_BACKOFF_DEG   = 8.0      # separarse del tope entre las dos pasadas
HOME_TIMEOUT_S     = 12.0     # por eje y por pasada
# Tras tocar el tope, separarse esto y declarar el cero AHI. Asi la posicion 0
# no deja el motor apoyado contra el tope forzando la transmision, y "volver a
# 0" es una orden segura.
HOME_ZERO_OFFSET_DEG = 5.0

# Los limites se calculan cuando ya se conocen los sentidos de referenciado.
SHOULDER_LIM = _limits_from_home(HOME_SHOULDER_SIGN, SHOULDER_TRAVEL_DEG)
ELBOW_LIM    = _limits_from_home(HOME_ELBOW_SIGN, ELBOW_TRAVEL_DEG)

# --- Garra: acerca/aleja el iman N52 ---
# Posiciones ABSOLUTAS del servo, comunes a todas las piezas (medidas en el
# brazo real). Hombro y codo solo situan el brazo en la casilla; la altura la
# pone el servo, asi que el servo tiene TRES posiciones, no dos:
#
#   ENGAGE  (0)    iman abajo, sobre la pieza: la agarra
#   LIFT    (110)  iman arriba CON la pieza: la levanta sin soltarla
#   RELEASE (170)  iman del todo arriba: la pieza se desprende
#
# ⚠️ servo_set solo acepta de 0 a 180: un angulo mayor se recorta a 180.
#
# ⚠️ Sin LIFT el brazo arrastraba la pieza por el tablero y se llevaba por
# delante a las vecinas. GRIPPER 1 hace las dos cosas seguidas (agarrar y
# levantar) y solo responde ACK cuando la pieza ya esta arriba, asi que el
# siguiente MOVE nunca sale con la pieza apoyada en el tablero.
#
# Si al subir, la pieza se SUELTA, LIFT esta demasiado cerca de RELEASE: bajalo.
# Si la pieza sigue rozando el tablero, subelo. None = no levantar (antiguo).
GRIPPER_ENGAGE_ANGLE  = 0     # iman CERCA de la pieza (la agarra)
GRIPPER_LIFT_ANGLE    = 110   # pieza agarrada y levantada (para transportarla)
GRIPPER_RELEASE_ANGLE = 170   # iman LEJOS de la pieza (la suelta)
GRIPPER_SETTLE_S      = 1     # tiempo para que el servo llegue
GRIPPER_GRAB_S        = 0.3   # abajo, antes de levantar: que el iman "pegue"

# Segundos que se espera al hotspot antes de rendirse y reintentar. Sin este
# limite la placa se cuelga esperando Wi-Fi y cuesta subirle un programa nuevo.
WIFI_TIMEOUT_S = 20

# Poner en False para dejar de imprimir el detalle de cada movimiento en la
# pantalla de la CyberPi una vez que el brazo este afinado.
VERBOSE = True

# =============================================================
# Nombres de API del shield mBot2: verificar en el autocompletado de mBlock
# que coincidan. Si alguno difiere, ajustar SOLO estas funciones _hw_*
# (y la llamada a EM_turn de _drive_turns, ver abajo).
#
# ⚠️ PILA DE LLAMADAS: el programa subido corre con MUY poca pila. Cada funcion
# que llama a otra gasta un poco, y las EM_* de la placa gastan bastante por
# dentro. Una sola funcion de mas en el camino de un MOVE bastaba para
# "ERR maximum recursion depth exceeded" ANTES de mover nada. No anadas
# funciones intermedias entre handle() y las EM_*: el test
# test_move_does_not_nest_deeper_than_the_board_allows lo vigila.
# =============================================================

def _hw_get_angle(port):
    return cyberpi.mbot2.EM_get_angle(port)

def _hw_turn(delta_deg, speed_rpm, port):
    _hw_hold(HOLD_ENABLED, port)
    cyberpi.mbot2.EM_turn(delta_deg, speed_rpm, port)   # RELATIVO, bloquea

def _hw_hold(enabled, port):
    # API de Makeblock, "APIs for Extension Boards", mBot2 / EM_lock:
    # https://www.yuque.com/makeblock-help-center-en/mcode/cyberpi-api-shields
    # La retencion esta desactivada por defecto en el firmware.
    lock = getattr(cyberpi.mbot2, "EM_lock", None)
    if lock is None:
        if enabled:
            raise ValueError("EM_lock no disponible: actualiza el firmware "
                             "de CyberPi/mBot2 para activar la retencion")
        return
    lock(enabled, port)

def _hw_set_power(power_pct, port):
    # TODO(verificar en mBlock): potencia cruda, sin control de posicion.
    # Es lo que permite empujar contra el tope durante el referenciado.
    cyberpi.mbot2.EM_set_power(power_pct, port)

def _hw_reset_angle(port):
    cyberpi.mbot2.EM_reset_angle(port)

def _hw_stop_axis(port):
    try:
        cyberpi.mbot2.EM_stop(port)
    finally:
        _hw_hold(False, port)

def _hw_stop():
    _hw_stop_axis("all")
    if ASSIST_ENABLED:
        try:
            _hw_assist(0)
        except Exception:
            pass        # parar los ejes principales importa mas que esto

def _hw_servo(angle):
    cyberpi.mbot2.servo_set(angle, GRIPPER_PORT)

def _hw_assist(power_pct):
    # ⚠️ TODO(verificar en mBlock): el geekservo esta en M1, que NO es un puerto
    # de motor encoder (esos son EM1/EM2, ya ocupados por hombro y codo), asi
    # que no se maneja con las EM_*. Comprueba en el autocompletado de mBlock
    # como se llama el control de un motor DC normal. Esta aislado aqui a
    # proposito, como el resto de los _hw_*: si el nombre es otro, se cambia
    # SOLO esta funcion y el resto del cliente no se entera.
    if ASSIST_KIND == "servo360":
        # Geekservo de rotacion continua: 90 = parado, y separarse de 90 marca
        # sentido y velocidad.
        cyberpi.mbot2.servo_set(90 + power_pct * 0.9, ASSIST_PORT)
        return
    drive = getattr(cyberpi.mbot2, "motor_set", None)
    if drive is None:
        raise ValueError("motor_set no disponible: comprueba ASSIST_KIND y el "
                         "puerto del geekservo, o pon ASSIST_ENABLED=False")
    drive(power_pct, ASSIST_PORT)


def _assist(direction):
    """Empuja (o para) el geekservo del hombro. ``direction`` es +1, -1 o 0.

    Solo acompana al tramo grueso. En el ultimo tramo NO: ahi se busca
    precision con impulsos pequenos, y un segundo actuador empujando de fondo
    se comeria justo el medio grado que se esta intentando afinar.
    """
    if not ASSIST_ENABLED:
        return
    _hw_assist(ASSIST_POWER * ASSIST_SIGN * direction)


def _log(text):
    if VERBOSE:
        cyberpi.console.println(text)


# ======================= MOVIMIENTO =======================

# Instante (time.time) a partir del cual un MOVE deja de afinar. 0 = sin limite
# (fuera de un MOVE, p. ej. durante HOME).
_deadline = 0.0


# Error aceptado en el MOVE en curso. El host lo sube (cuarto argumento de
# MOVE) para las poses de FUERA del tablero (descarte, reposo): ahi no hace
# falta precision y afinar los ultimos grados era lo que mas tardaba. _slack
# es lo que se relaja sobre lo normal; con el se corren tambien los umbrales de
# repaso y de fallo. Se restablecen en handle() al acabar cada MOVE.
_tol = TOLERANCE_DEG
_slack = 0.0


def _out_of_time():
    return _deadline > 0 and time.time() > _deadline


def _clamp(v, lim, name):
    lo, hi = lim
    if not lo <= v <= hi:
        raise ValueError(
            name + " fuera de limites: " + str(v) + " no esta en ["
            + str(lo) + ", " + str(hi) + "]. Recuerda que el recorrido util va"
            + " del lado contrario al tope.")
    return v


def _drive_turns(target, port, current, name):
    """Tramo grueso con EM_turn, subiendo la velocidad si una pasada se queda
    corta.

    EM_turn es RELATIVO y bajo carga no cubre el giro entero, asi que se repite
    la correccion en vez de mandar un solo giro y confiar. La clave esta en el
    criterio: una pasada que cubre menos de MOVE_PROGRESS_RATIO de lo pedido no
    es un eje trabado, es un eje al que a esa velocidad no le llega el par, y la
    siguiente va MAS RAPIDA. OJO: el eje suele avanzar algo (un cuarto del
    camino), asi que "no se ha movido nada" no lo detecta.

    Devuelve el angulo alcanzado; los ultimos grados los cierra _creep_to.
    """
    speed = MOVE_SPEED_RPM
    for _ in range(MOVE_MAX_PASSES):
        delta = target - current
        if abs(delta) <= _tol or _out_of_time():
            break
        # EM_turn directo y no via _hw_turn: es el punto MAS PROFUNDO de un
        # MOVE (EM_turn anida bastante por dentro) y cada funcion de menos es
        # margen de pila. Ver PILA DE LLAMADAS arriba.
        _hw_hold(HOLD_ENABLED, port)
        cyberpi.mbot2.EM_turn(delta, speed, port)   # RELATIVO, bloquea
        time.sleep(MOVE_SETTLE_S)
        previous = current
        current = _hw_get_angle(port)
        if abs(current - previous) < abs(delta) * MOVE_PROGRESS_RATIO:
            if speed >= MOVE_SPEED_MAX_RPM:
                break          # ya va al maximo: que lo termine _creep_to
            speed = min(speed + MOVE_SPEED_STEP_RPM, MOVE_SPEED_MAX_RPM)
            _log("  " + name + " corto, subo a " + str(speed) + " rpm")
    return current


def _creep_to(target, port, name):
    """Cierra el ultimo tramo a impulsos de POTENCIA cruda.

    Aqui no se usa EM_turn a proposito: pedir "gira 2 grados" se traduce en muy
    pocas RPM, y a pocas RPM el PWM no vence el peso del brazo. La potencia
    cruda no depende del error (es la misma con la que HOME empuja contra el
    tope), asi que hay par aunque falte medio grado. A cambio no sabe frenar
    sola: se aplica en impulsos cortos, leyendo el encoder entre uno y otro, y
    cada impulso MIDE el ritmo real para dimensionar el siguiente.

    La retencion se suelta mientras dura (igual que en _seek_stop: no tiene
    sentido pelear contra ella) y se vuelve a activar al terminar.
    """
    _hw_hold(False, port)
    current = _hw_get_angle(port)
    power = CREEP_POWER
    rate = 0.0          # grados/segundo medidos; 0 = todavia no se sabe
    last_sign = 0
    flips = 0
    try:
        for _ in range(CREEP_MAX_PULSES):
            error = target - current
            if abs(error) <= _tol or _out_of_time():
                break
            sign = 1 if error > 0 else -1
            if last_sign != 0 and sign != last_sign:
                # Hemos cruzado el objetivo: bajar a la potencia minima para no
                # oscilar. El ritmo medido SI se conserva: es lo unico que evita
                # repetir el impulso que se paso de largo.
                flips += 1
                if flips > CREEP_MAX_FLIPS:
                    break
                power = CREEP_POWER
            last_sign = sign

            # Duracion: la que hace falta, al ritmo medido en el impulso
            # anterior, para cubrir CREEP_AIM de lo que queda. Sin medida
            # todavia, el mas corto posible (que es el que la toma).
            if rate > 0.0:
                pulse = abs(error) * CREEP_AIM / rate
                if pulse < CREEP_PULSE_MIN_S:
                    # Ni el impulso mas corto cabe en lo que queda: con un brazo
                    # rapido, 50 ms ya se pasan de largo. Para moverse MENOS hay
                    # que empujar mas flojo, no mas rato, asi que se baja la
                    # potencia en la misma proporcion.
                    power = max(CREEP_POWER_MIN,
                                power * pulse / CREEP_PULSE_MIN_S)
                    pulse = CREEP_PULSE_MIN_S
                    rate = 0.0      # a otra potencia, el ritmo anterior no vale
                else:
                    pulse = min(pulse, CREEP_PULSE_MAX_S)
            else:
                pulse = CREEP_PULSE_MIN_S

            _hw_hold(False, port)       # no empujar contra la retencion...
            _hw_set_power(power * sign, port)
            time.sleep(pulse)
            _hw_stop_axis(port)
            # ...pero SI sostener durante la pausa. Sin esto, un eje con carga
            # (el hombro) perdia en cada pausa lo que ganaba en el impulso, y
            # el repaso nunca lo devolvia a su sitio.
            _hw_hold(HOLD_ENABLED, port)
            time.sleep(CREEP_REST_S)

            previous = current
            current = _hw_get_angle(port)
            moved = abs(current - previous)
            if moved < CREEP_MIN_DELTA_DEG:
                # El impulso no ha movido nada: falta par, no duracion.
                if power >= CREEP_POWER_MAX:
                    break       # ni a tope se mueve: el problema no es el PWM
                power = min(power + CREEP_POWER_STEP, CREEP_POWER_MAX)
                rate = 0.0      # a otra potencia, el ritmo anterior no vale
                _log("  " + name + " impulso a " + str(power) + "%")
            else:
                # Incluye lo que el eje rueda tras cortar la potencia, asi que
                # el ritmo sale algo alto y los impulsos, algo cortos. Mejor
                # quedarse corto y repetir que pasarse.
                rate = moved / pulse
    finally:
        _hw_stop_axis(port)             # _hw_stop_axis deja la retencion off...
        _hw_hold(HOLD_ENABLED, port)    # ...asi que hay que volver a sostener
    return current


def _move_axis(target, port, lim, name, approach=True):
    """Lleva el eje a ``target`` (grados de motor absolutos) y lo VERIFICA.

    Dos fases: el tramo grueso con EM_turn y, si aun falta, el ultimo tramo a
    impulsos de potencia. Devuelve el angulo realmente alcanzado.

    ``approach=False`` salta la compensacion de juego: es para los repasos de
    unos pocos grados. Con ella, un eje que se habia pasado un poco retrocedia
    BACKLASH_DEG, volvia a pasarse, retrocedia otra vez... y el brazo se
    quedaba "buscando" la casilla hasta el timeout del host.
    """
    target = _clamp(target, lim, name)
    _hw_hold(HOLD_ENABLED, port)
    start = _hw_get_angle(port)

    # Compensacion de juego: si vinieramos "del lado contrario", pasarse un
    # poco para que el tramo final entre siempre en el mismo sentido. Con
    # _drive_turns y no con un solo giro: si el giro se queda corto, el eje
    # seguiria del lado malo y la compensacion no serviria de nada.
    approach_sign = (SHOULDER_APPROACH_SIGN if port == SHOULDER_PORT
                     else ELBOW_APPROACH_SIGN)
    # Sin precision (fuera del tablero) el juego da igual: no se compensa.
    if (approach and BACKLASH_DEG > 0 and _slack <= 0
            and (target - start) * approach_sign < -_tol):
        pre = max(lim[0], min(lim[1], target - approach_sign * BACKLASH_DEG))
        _drive_turns(pre, port, start, name)

    current = _hw_get_angle(port)
    if port == SHOULDER_PORT and abs(target - current) > _tol:
        _assist(1 if target > current else -1)
    try:
        current = _drive_turns(target, port, current, name)
    finally:
        if port == SHOULDER_PORT:
            _assist(0)      # que un fallo no deje el geekservo empujando
    if abs(target - current) > _tol:
        current = _creep_to(target, port, name)

    error = target - current
    if VERBOSE:
        _log("  " + name + " " + str(start) + "->" + str(current)
             + " obj " + str(target) + " err " + str(round(error, 2)))
    if abs(error) > MOVE_FAIL_DEG + _slack:
        raise ValueError(
            name + " no alcanzo " + str(target) + " (quedo en " + str(current)
            + "). Bateria baja, potencia insuficiente o tope mecanico?")
    return current


def _move_all(shoulder, elbow):
    """Valida ambos destinos antes de mover y verifica la pose FINAL completa.

    El orden importa dos veces. Estetico: con el hombro primero el brazo gira
    sobre su base y luego se despliega (y barre menos tablero, porque el codo
    sigue recogido durante el giro). Y fisico: mover el segundo eje cambia el
    par que aguanta el primero, asi que el primero puede ceder DESPUES de darlo
    por bueno. La retencion del shield deberia evitarlo; si aun asi cede un poco
    se corrige, y si no se deja corregir es que la retencion no esta haciendo su
    trabajo y hay que decirlo en vez de mover el brazo a ciegas.
    """
    global _deadline
    _clamp(shoulder, SHOULDER_LIM, "hombro")
    _clamp(elbow, ELBOW_LIM, "codo")
    _hw_hold(HOLD_ENABLED, "all")
    # El limite se QUITA en handle(), no aqui con un try/finally envolviendo
    # otra funcion: esa funcion de mas fue la que desbordo la pila (ver
    # PILA DE LLAMADAS arriba).
    _deadline = time.time() + MOVE_BUDGET_S

    shoulder_axis = (shoulder, SHOULDER_PORT, SHOULDER_LIM, "hombro")
    elbow_axis = (elbow, ELBOW_PORT, ELBOW_LIM, "codo")
    if MOVE_SHOULDER_FIRST:
        order = (shoulder_axis, elbow_axis)
    else:
        order = (elbow_axis, shoulder_axis)
    for target, port, lim, name in order:
        _move_axis(target, port, lim, name)

    # Repaso del eje que haya cedido. Aqui no se da error: el diagnostico de
    # verdad lo da la verificacion final, con la pose que queda de verdad.
    # Mas de una ronda porque corregir un eje cambia la carga del otro.
    for _ in range(MOVE_SAG_PASSES):
        if _out_of_time():
            _log("  sin tiempo para repasar")
            break
        time.sleep(MOVE_SETTLE_S)
        sagged = False
        for target, port, lim, name in order:
            if abs(target - _hw_get_angle(port)) > MOVE_SAG_DEG + _slack:
                sagged = True
                _log("  " + name + " cedio, repaso")
                try:
                    _move_axis(target, port, lim, name, approach=False)
                except ValueError:
                    pass
        if not sagged:
            break

    # No devolver la lectura anterior como si siguiera siendo la actual.
    got_sh = _hw_get_angle(SHOULDER_PORT)
    got_el = _hw_get_angle(ELBOW_PORT)
    for name, target, current in (("hombro", shoulder, got_sh),
                                  ("codo", elbow, got_el)):
        if abs(target - current) > MOVE_FAIL_DEG + _slack:
            raise ValueError(name + " no mantuvo " + str(target)
                             + " (quedo en " + str(current)
                             + "). Revisa retencion, bateria y carga del brazo.")
    return got_sh, got_el


# ======================= GARRA =======================

def _grab():
    """Baja el iman sobre la pieza, la agarra y la LEVANTA sin soltarla.

    Levantarla es lo que evita arrastrarla por el tablero en el MOVE siguiente
    (y llevarse por delante a las piezas vecinas). Todo va en un mismo comando
    para que el host no tenga que acordarse: cuando llega el ACK, la pieza ya
    esta arriba.
    """
    _hw_servo(GRIPPER_ENGAGE_ANGLE)
    time.sleep(GRIPPER_SETTLE_S + GRIPPER_GRAB_S)
    if GRIPPER_LIFT_ANGLE is not None:
        _hw_servo(GRIPPER_LIFT_ANGLE)
        time.sleep(GRIPPER_SETTLE_S)


# ======================= REFERENCIADO (HOME) =======================

def _seek_stop(port, sign, power, name):
    """Empuja el eje contra su tope y para cuando el encoder deja de cambiar.

    Deteccion de tope sin sensor: si el motor tiene potencia aplicada y el
    angulo no cambia durante varias muestras seguidas, esta apoyado.
    """
    _hw_hold(False, port)       # no luchar contra la retencion al buscar tope
    _hw_set_power(power * sign, port)
    last = _hw_get_angle(port)
    still = 0
    moved = False
    t0 = time.time()
    try:
        while True:
            time.sleep(HOME_SAMPLE_S)
            now = _hw_get_angle(port)
            if abs(now - last) >= HOME_MIN_DELTA_DEG:
                moved = True
                still = 0
            else:
                still += 1
            last = now
            elapsed = time.time() - t0
            # No declarar tope durante el arranque (el motor tarda en romper
            # la inercia y las primeras muestras parecen "quieto").
            if still >= HOME_STILL_N and elapsed > HOME_START_GRACE_S and moved:
                return now
            if elapsed > HOME_TIMEOUT_S:
                raise ValueError(
                    "referenciado de " + name + ": no encontre el tope en "
                    + str(HOME_TIMEOUT_S) + "s. Sentido invertido o potencia baja?")
    finally:
        _hw_stop_axis(port)


def _home_axis(port, sign, name):
    """Referencia un eje en dos pasadas y declara el cero cerca del tope.

    El cero NO queda exactamente en el tope sino ``HOME_ZERO_OFFSET_DEG``
    separado de el: asi la posicion 0 es una orden segura y no deja el motor
    apoyado forzando la transmision.
    """
    _log("home " + name + "...")
    _seek_stop(port, sign, HOME_POWER, name)          # pasada rapida
    _hw_turn(-sign * HOME_BACKOFF_DEG, MOVE_SPEED_FINE_RPM, port)
    time.sleep(MOVE_SETTLE_S)
    _seek_stop(port, sign, HOME_POWER_FINE, name)     # pasada lenta y precisa
    time.sleep(0.2)
    # Separarse del tope ANTES de fijar el cero.
    _hw_turn(-sign * HOME_ZERO_OFFSET_DEG, MOVE_SPEED_FINE_RPM, port)
    time.sleep(MOVE_SETTLE_S)
    _hw_stop_axis(port)         # descartar la referencia de retencion anterior
    _hw_reset_angle(port)
    _hw_hold(HOLD_ENABLED, port)
    _log("  " + name + " cero fijado")


def _home_all():
    """Referencia los dos ejes. El CODO primero: se recoge sobre si mismo y
    el brazo no barre el tablero mientras el hombro busca su tope."""
    _hw_hold(HOLD_ENABLED, "all")
    _home_axis(ELBOW_PORT, HOME_ELBOW_SIGN, "codo")
    _home_axis(SHOULDER_PORT, HOME_SHOULDER_SIGN, "hombro")


# ======================= LOGICA DE COMANDOS =======================

def handle(line):
    parts = line.split()
    if not parts:
        return None
    cmd = parts[0].upper()

    if cmd == "PING":
        return "ACK PONG"

    if cmd == "HOME":
        if not HOMING_ENABLED:
            return "ERR referenciado desactivado (HOMING_ENABLED=False)"
        _home_all()
        sh = _hw_get_angle(SHOULDER_PORT)
        el = _hw_get_angle(ELBOW_PORT)
        return "ACK HOME " + str(sh) + " " + str(el)

    if cmd == "LIMITS":
        # Para que el host sepa hacia que lado puede mover cada eje sin
        # tener que adivinar el sentido de referenciado.
        return ("ACK LIMITS " + str(SHOULDER_LIM[0]) + " " + str(SHOULDER_LIM[1])
                + " " + str(ELBOW_LIM[0]) + " " + str(ELBOW_LIM[1]))

    if cmd == "ZERO":
        _hw_stop()             # ZERO es manual; no conservar un objetivo viejo
        _hw_reset_angle(SHOULDER_PORT)
        _hw_reset_angle(ELBOW_PORT)
        return "ACK ZERO"

    if cmd == "MOVE":
        if len(parts) not in (3, 4):
            return "ERR MOVE requiere 2 o 3 argumentos"
        sh = float(parts[1])
        el = float(parts[2])
        global _deadline, _tol, _slack
        if len(parts) == 4:
            # Nunca MAS exigente que lo normal: solo se puede relajar.
            _tol = max(TOLERANCE_DEG, float(parts[3]))
            _slack = _tol - TOLERANCE_DEG
        try:
            got_sh, got_el = _move_all(sh, el)
        finally:
            _deadline = 0.0         # fuera de un MOVE no hay limite de tiempo
            _tol = TOLERANCE_DEG    # el siguiente MOVE vuelve a ir fino
            _slack = 0.0
        return "ACK MOVE " + str(got_sh) + " " + str(got_el)

    if cmd == "GRIPPER":
        if len(parts) != 2:
            return "ERR GRIPPER requiere 1 argumento"
        if parts[1] == "1":
            _grab()
        else:
            _hw_servo(GRIPPER_RELEASE_ANGLE)
            time.sleep(GRIPPER_SETTLE_S)
        return "ACK GRIPPER"

    if cmd == "GET":
        sh = _hw_get_angle(SHOULDER_PORT)
        el = _hw_get_angle(ELBOW_PORT)
        return "ACK POS " + str(sh) + " " + str(el)

    if cmd == "STOP":
        _hw_stop()
        return "ACK STOP"

    return "ERR comando desconocido: " + cmd


# ======================= RED =======================

def conectar_wifi():
    """Conecta al hotspot. Devuelve True si lo consiguio, False si no.

    ⚠️ CON TIEMPO LIMITE A PROPOSITO. Un bucle "hasta que conecte" sin salida
    deja la placa colgada si el hotspot no esta encendido, y entonces cuesta
    que mBlock recupere el puerto para subir un programa nuevo. Mejor rendirse,
    avisar en pantalla y reintentar desde el bucle principal.
    """
    cyberpi.console.println("WiFi: " + SSID)
    cyberpi.led.on("yellow")
    cyberpi.wifi.connect(SSID, PASS)
    t0 = time.time()
    while not cyberpi.wifi.is_connect():
        if time.time() - t0 > WIFI_TIMEOUT_S:
            cyberpi.console.println("Sin WiFi, reintento")
            cyberpi.led.on("red")
            return False
        time.sleep(0.5)
    cyberpi.console.println("WiFi OK")
    time.sleep(3)   # dar tiempo a DHCP
    return True

def sesion():
    """Una conexion al host. Vuelve cuando se cae, para reintentar."""
    cyberpi.console.println("-> host " + MAC_IP)
    sock = usocket.socket(usocket.AF_INET, usocket.SOCK_STREAM)
    sock.connect((MAC_IP, PORT))
    cyberpi.console.println("CONECTADO")
    cyberpi.led.on("green")

    buf = b""
    try:
        while True:
            data = sock.recv(128)
            if not data:
                break                      # host cerro
            buf += data
            while b"\n" in buf:
                raw, buf = buf.split(b"\n", 1)
                line = raw.decode().strip()
                if not line:
                    continue
                cyberpi.console.println("> " + line)
                try:
                    resp = handle(line)
                except Exception as e:
                    _hw_stop()             # nunca dejar un motor empujando
                    resp = "ERR " + str(e)
                if resp:
                    cyberpi.console.println("< " + resp)
                    sock.send((resp + "\n").encode())
    finally:
        try:
            _hw_stop()
        finally:
            sock.close()


# ======================= ARRANQUE =======================

# Este archivo se pega en mBlock: ejecutar directamente, sin depender del
# valor de __name__ que le asigne el cargador de programas de la placa.
# Los tests ejecutan este mismo arranque con CyberPi y red simuladas.
cyberpi.console.clear()
cyberpi.console.println("MAGNUS arm client (retencion)")
cyberpi.led.on("blue")       # arranque visible ANTES de consultar Wi-Fi

# Bucle de servicio existente de la placa.
while True:
    try:
        if cyberpi.wifi.is_connect() or conectar_wifi():
            sesion()
    except Exception as e:
        cyberpi.console.println("Error cliente: " + str(e))
        cyberpi.led.on("red")
    _hw_stop()          # que un fallo de red nunca deje un motor empujando
    time.sleep(2)       # esperar antes de reintentar
