LeoZ24/MAGNUS_Chess_Robot/tests/test_app_controller.py

"""Tests del controlador de la aplicación con cámara sintética y dobles."""

import json
import time
from pathlib import Path
from types import SimpleNamespace
from unittest.mock import Mock, patch

import pytest

from magnus import config
from magnus.app.controller import MagnusController
from magnus.app.arm_bridge import ArmSupervisor
from magnus.app.session import SyntheticCamera
from magnus.app.settings import AppSettings
from magnus.arm.backend import FakeArmBackend
from magnus.arm.positions_table import PositionsTable
from magnus.vision.vision_node import CameraBackend, CameraError
from magnus.voice.backend import FakeSpeechBackend

from app_fakes import RandomEngineBackend, fake_engine_factory


def _wait_engine(controller, timeout=5.0):
    deadline = time.monotonic() + timeout
    while time.monotonic() < deadline:
        controller.step()
        if controller.engine.status == "listo":
            return True
        time.sleep(0.01)
    return False


def _run(controller, frames, until=None, sleep=0.0):
    for _ in range(frames):
        controller.step()
        if until is not None and until(controller.snapshot()):
            return True
        if sleep:
            time.sleep(sleep)
    return False


@pytest.fixture
def controller(tmp_path):
    settings = AppSettings(difficulty="EASY", arm_mode="simulated", arm_auto_execute=True)
    backend = RandomEngineBackend()
    ctrl = MagnusController(
        settings,
        settings_path=str(tmp_path / "settings.json"),
        synthetic=True,
        engine_factory=fake_engine_factory(backend),
        voice_backend=FakeSpeechBackend(),
        arm_step_delay_s=0.0,
    )
    ctrl.engine_backend = backend
    ctrl.start_without_thread()
    yield ctrl
    ctrl.shutdown()


def test_setup_phase_sees_initial_position(controller):
    assert _wait_engine(controller)
    _run(controller, 20)
    snap = controller.snapshot()
    assert snap["phase"] == "setup" and snap["sub"] == "ready"
    assert snap["setup"]["pieces_detected"] == 32 and snap["setup"]["corners"] == 4
    assert snap["camera"]["synthetic"] and snap["camera"]["ok"]
    assert snap["engine"]["status"] == "listo"
    assert snap["arm"]["mode"] == "simulated" and snap["arm"]["status"] == "ready"
    json.dumps(snap)                          # serializable para la API
    jpeg, seq = controller.latest_jpeg()
    assert jpeg and jpeg[:2] == b"\xff\xd8" and seq > 0


def test_full_synthetic_game_with_simulated_arm(controller):
    assert _wait_engine(controller)
    controller.command("start_game")
    assert _run(controller, 4000, until=lambda s: len(s["history"]) >= 6, sleep=0.001)
    snap = controller.snapshot()
    assert snap["phase"] == "playing" and snap["in_game"]
    assert snap["history"][0] == "e4"                  # guion del humano
    assert snap["arm"]["last_outcome"] == "done"       # el brazo simulado movió
    assert snap["eval"]["label"] is not None           # la barra tiene datos
    assert any("Brazo ejecutando" in e["text"] for e in snap["events"])
    spoken = controller.voice.backend.spoken
    assert spoken and any("Muevo" in t or "muevo" in t for t in spoken)


def test_real_arm_move_counts_once_the_piece_is_released():
    """Con el brazo real la jugada se da por hecha al soltar la pieza, sin
    esperar a que la cámara la confirme (el brazo se la tapa al trabajar)."""
    path = str(Path(__file__).resolve().parents[1] / "magnus/arm/positions.json")
    settings = AppSettings(robot_side="white", arm_mode="cyberpi",
                           arm_auto_execute=True, positions_path=path)
    backend = FakeArmBackend()
    arm = ArmSupervisor(mode="cyberpi", positions_path=path,
                        backend_factory=lambda port: backend)
    camera = SyntheticCamera()  # Imagen controlada a mano, sin guion de demo.
    ctrl = MagnusController(settings, camera=camera, arm=arm,
                            engine_factory=fake_engine_factory(), voice_backend=FakeSpeechBackend())
    ctrl.start_without_thread()
    ctrl.voice.say_your_turn = Mock()
    try:
        assert _wait_engine(ctrl)
        _run(ctrl, 20)
        ctrl.command("start_game")
        assert _run(ctrl, 500, until=lambda s: s["board"]["planned"] is not None, sleep=0.001)
        planned = ctrl.session.planned
        assert _run(ctrl, 500, until=lambda s: len(s["history"]) == 1, sleep=0.001)
        table = PositionsTable.load(path)
        source = table.get(planned.from_square).position
        dest = table.get(planned.to_square).position
        expected = [
            ("connect",), ("home",), ("gripper", False),
            ("move_to", source.shoulder, source.elbow), ("gripper", True),
            ("move_to", dest.shoulder, dest.elbow), ("gripper", False),
        ]
        if table.has(config.ZONE_PARK):     # la tabla real ya trae el reposo
            park = table.get(config.ZONE_PARK).position
            expected.append(("move_to", park.shoulder, park.elbow))
        assert backend.commands == expected
        _run(ctrl, 5)
        assert len(backend.commands) == len(expected)      # una sola vez
        assert ctrl.session.history_san == [planned.san]    # sin que la cámara lo vea
        assert ctrl.snapshot()["sub"] == "human_turn"
        ctrl.voice.say_your_turn.assert_called_once()
        assert ctrl._arm_done_uci is None  # Se puede volver a jugar esa UCI más adelante.
        # Cuando la cámara ve por fin la pieza colocada, no cuenta otra jugada.
        assert camera.push(planned.uci)
        _run(ctrl, 30)
        assert ctrl.session.history_san == [planned.san]
    finally:
        ctrl.shutdown()


def test_arm_does_not_start_from_an_unconfirmed_board(controller):
    assert _wait_engine(controller)
    controller.command("start_game")
    controller.settings = controller.settings.update(arm_auto_execute=False)
    assert _run(controller, 1000, until=lambda s: s["arm"]["pending"], sleep=0.001)
    controller._stable = 0
    controller.settings = controller.settings.update(arm_auto_execute=True)
    with patch.object(controller.arm, "execute") as execute:
        controller._arm_logic()
        controller._cmd_arm_execute()
        execute.assert_not_called()


def test_stop_holds_only_the_current_move(controller):
    assert _wait_engine(controller)
    controller.command("start_game")
    controller.settings = controller.settings.update(arm_auto_execute=False)
    assert _run(controller, 1000, until=lambda s: s["arm"]["pending"], sleep=0.001)
    controller.settings = controller.settings.update(arm_auto_execute=True)
    controller._cmd_arm_stop()
    # El modo automático sigue activo, pero esa jugada ya no se lanza sola.
    assert controller.settings.arm_auto_execute
    with patch.object(controller.arm, "execute") as execute:
        controller._arm_logic()
        execute.assert_not_called()
    controller._publish_snapshot()
    snap = controller.snapshot()["arm"]
    assert snap["pending"] and snap["held"] and snap["auto_execute"]


def test_failed_arm_move_requires_manual_retry(controller):
    controller.in_game = True
    controller._cmd__arm_finished("e2e4", False, "motor atascado", controller.session.tracker.fen())
    assert controller.settings.arm_auto_execute
    assert controller._arm_held_uci == "e2e4"
    assert controller._arm_pending


def test_next_robot_move_is_automatic_again_after_a_hold(controller):
    controller._arm_held_uci = "e2e4"
    controller._on_move_seen("e4")
    assert controller._arm_held_uci is None


def test_camera_does_not_confirm_a_move_while_arm_is_busy():
    ctrl = MagnusController(AppSettings(robot_side="white"),
                            engine_enabled=False, voice_enabled=False)
    ctrl.in_game = True
    ctrl.pose = object()  # Solo interesa que exista una pose para aplicar el placement.
    ctrl._stable = 100
    ctrl._placement = ctrl.session.tracker.placement()
    ctrl._placement["e4"] = ctrl._placement.pop("e2")
    ctrl.arm = SimpleNamespace(is_busy=True)
    ctrl._game_logic()
    assert ctrl.session.history_san == []
    ctrl.arm.is_busy = False
    ctrl._game_logic()
    assert ctrl.session.history_san == ["e4"]


def test_set_difficulty_applies_and_persists(controller, tmp_path):
    assert _wait_engine(controller)
    controller.command("set_difficulty", {"level": "expert"})
    _run(controller, 5, sleep=0.01)
    snap = controller.snapshot()
    assert snap["settings"]["difficulty"] == "EXPERT"
    assert snap["engine"]["difficulty"] == "EXPERT"
    saved = json.loads((tmp_path / "settings.json").read_text())
    assert saved["difficulty"] == "EXPERT"
    controller.command("start_game")
    assert _run(controller, 3000, until=lambda s: len(s["history"]) >= 2, sleep=0.001)
    played = [d for d in controller.engine_backend.difficulties_seen if d != "ANALYSIS"]
    assert played and played[-1] == "EXPERT"


def test_arm_manual_execution_requires_button(tmp_path):
    settings = AppSettings(arm_mode="simulated", arm_auto_execute=False)
    ctrl = MagnusController(settings, synthetic=True,
                            engine_factory=fake_engine_factory(),
                            voice_enabled=False, arm_step_delay_s=0.0)
    ctrl.start_without_thread()
    try:
        assert _wait_engine(ctrl)
        ctrl.command("start_game")
        assert _run(ctrl, 2000, until=lambda s: s["arm"]["pending"], sleep=0.001)
        snap = ctrl.snapshot()
        assert snap["sub"] == "robot_ready" and snap["board"]["planned"]["uci"]
        assert snap["arm"]["preview"]                    # secuencia visible antes
        # Sin pulsar el botón el brazo no se mueve aunque pasen frames.
        _run(ctrl, 60)
        assert ctrl.snapshot()["arm"]["last_outcome"] is None
        ctrl.command("arm_execute")
        assert _run(ctrl, 2000, until=lambda s: s["arm"]["last_outcome"] == "done", sleep=0.001)
        assert _run(ctrl, 2000, until=lambda s: len(s["history"]) >= 2, sleep=0.001)
    finally:
        ctrl.shutdown()


def test_commands_change_settings_and_modes(controller, tmp_path):
    assert _wait_engine(controller)
    controller.command("set_robot_side", {"side": "white"})
    controller.command("set_voice", {"muted": True, "announce_human_moves": True, "idle_prompt_s": 10})
    controller.command("set_arm", {"mode": "off", "auto_execute": False})
    controller.command("flip_view")
    controller.command("rotate_mapping")
    _run(controller, 3)
    s = controller.snapshot()["settings"]
    assert s["robot_side"] == "white" and s["voice_muted"] and s["announce_human_moves"]
    assert s["idle_prompt_s"] == 10 and s["arm_mode"] == "off" and s["flip_view"]
    assert s["board_turns"] == 1
    assert controller.snapshot()["arm"]["status"] == "off"
    assert controller.voice.is_muted
    # CyberPi sin tabla: error explicado, nunca una excepción.
    controller.command("set_arm", {"mode": "cyberpi", "positions_path": str(tmp_path / "no.json")})
    _run(controller, 3)
    arm = controller.snapshot()["arm"]
    assert arm["mode"] == "cyberpi" and arm["status"] == "error" and arm["positions"]["exists"] is False
    # Comando desconocido: rechazado sin tocar nada.
    assert controller.command("hack_the_planet")["ok"] is False


def test_stop_game_returns_to_setup(controller):
    assert _wait_engine(controller)
    controller.command("start_game")
    _run(controller, 5)
    assert controller.snapshot()["in_game"]
    controller.command("stop_game")
    _run(controller, 3)
    snap = controller.snapshot()
    assert not snap["in_game"] and snap["phase"] == "setup"


def test_camera_failure_keeps_controller_alive():
    class DeadCamera(CameraBackend):
        def open(self):
            raise CameraError("no hay cámara")

        def read(self):
            raise CameraError("no hay cámara")

        def close(self):
            pass

    ctrl = MagnusController(AppSettings(), camera=DeadCamera(), engine_enabled=False,
                            voice_enabled=False)
    ctrl.start_without_thread()
    try:
        _run(ctrl, 3)
        snap = ctrl.snapshot()
        assert snap["camera"]["ok"] is False and "cámara" in snap["camera"]["error"]
        assert snap["phase"] == "setup" and snap["engine"]["enabled"] is False
        ctrl.command("start_game")
        _run(ctrl, 2)
        assert not ctrl.snapshot()["in_game"]
        assert any(e["kind"] == "warn" for e in ctrl.snapshot()["events"])
    finally:
        ctrl.shutdown()


def test_threaded_start_and_shutdown(tmp_path):
    ctrl = MagnusController(AppSettings(arm_mode="off"), synthetic=True, engine_enabled=False,
                            voice_enabled=False)
    with ctrl:
        deadline = time.monotonic() + 5
        while time.monotonic() < deadline and ctrl.seq < 5:
            time.sleep(0.02)
        assert ctrl.seq >= 5
        jpeg, seq = ctrl.wait_for_jpeg(0, timeout=2.0)
        assert jpeg is not None and seq > 0


def test_arm_home_command_references_the_arm(tmp_path):
    """El botón "Referenciar" llega al brazo y avisa por evento al terminar."""
    settings = AppSettings(arm_mode="simulated", arm_auto_execute=False)
    ctrl = MagnusController(settings, synthetic=True,
                            engine_factory=fake_engine_factory(),
                            voice_enabled=False, arm_step_delay_s=0.0)
    ctrl.start_without_thread()
    try:
        backend = ctrl.arm._node._backend
        ctrl.command("arm_home")
        assert _run(ctrl, 2000, until=lambda s: ("home",) in backend.commands,
                    sleep=0.001)
        texts = [e["text"] for e in ctrl.snapshot()["events"]]
        assert any("eferenciad" in t for t in texts)
    finally:
        ctrl.shutdown()


def test_arm_home_is_refused_while_the_arm_is_off(tmp_path):
    settings = AppSettings(arm_mode="off")
    ctrl = MagnusController(settings, synthetic=True,
                            engine_factory=fake_engine_factory(),
                            voice_enabled=False, arm_step_delay_s=0.0)
    ctrl.start_without_thread()
    try:
        ctrl.command("arm_home")
        _run(ctrl, 5)
        texts = [e["text"] for e in ctrl.snapshot()["events"]]
        assert any("apagado" in t for t in texts)
    finally:
        ctrl.shutdown()


def test_set_arm_persists_auto_home(tmp_path):
    path = tmp_path / "s.json"
    settings = AppSettings(arm_mode="simulated")
    ctrl = MagnusController(settings, synthetic=True, settings_path=str(path),
                            engine_factory=fake_engine_factory(),
                            voice_enabled=False, arm_step_delay_s=0.0)
    ctrl.start_without_thread()
    try:
        ctrl.command("set_arm", {"auto_home": False})
        _run(ctrl, 5)
        assert ctrl.settings.arm_auto_home is False
        assert ctrl.arm.auto_home is False
        assert json.loads(path.read_text(encoding="utf-8"))["arm_auto_home"] is False
    finally:
        ctrl.shutdown()


# --------------------------------------------------------------------------- #
# La jugada del brazo se da por hecha al soltar la pieza (sin la cámara)
# --------------------------------------------------------------------------- #

from magnus.app.arm_bridge import release_index  # noqa: E402


def _pending_move(controller):
    """Partida empezada y jugada del robot esperando el botón."""
    assert _wait_engine(controller)
    controller.command("start_game")
    controller.settings = controller.settings.update(arm_auto_execute=False)
    assert _run(controller, 1000, until=lambda s: s["arm"]["pending"], sleep=0.001)
    planned = controller.session.planned
    return planned, controller.arm._planner.plan(planned)


def test_screen_follows_the_arm_before_the_move_counts(controller):
    planned, plan = _pending_move(controller)
    before = list(controller.session.history_san)
    progress = (planned.uci, plan, release_index(plan) + 1)
    with patch.object(controller.arm, "progress", return_value=progress):
        controller._publish_snapshot()
    snap = controller.snapshot()
    assert snap["board"]["placement"][planned.to_square]
    assert planned.from_square not in snap["board"]["placement"]
    assert snap["history"] == before


def test_move_counts_as_soon_as_the_piece_is_released(controller):
    planned, plan = _pending_move(controller)
    before = list(controller.session.history_san)
    fen_before = controller.session.tracker.fen()
    with patch.object(controller.arm, "progress",
                      return_value=(planned.uci, plan, release_index(plan))):
        controller._arm_progress_logic()
    assert controller.session.history_san == before  # aún lleva la pieza
    with patch.object(controller.arm, "progress",
                      return_value=(planned.uci, plan, release_index(plan) + 1)):
        controller._arm_progress_logic()
        controller._arm_progress_logic()             # no se apunta dos veces
    assert controller.session.history_san == before + [planned.san]
    assert controller.synth.board.fen() == controller.session.tracker.fen()
    # Que falle la retirada después no la deshace ni deja nada pendiente.
    controller._cmd__arm_finished(planned.uci, False, "ERR al retirarse", fen_before)
    assert controller.session.history_san == before + [planned.san]
    assert controller._arm_held_uci is None
    assert not controller._arm_pending


def test_simulated_arm_with_a_real_camera_still_waits_for_it(controller):
    """El brazo simulado no mueve nada: con cámara real, la pieza la pone el
    humano y la jugada la confirma la cámara, como siempre."""
    assert controller._arm_assumes_success()
    controller.synth = None
    assert not controller._arm_assumes_success()
