LeoZ24/MAGNUS_Chess_Robot/(commit log)

2026-06-13 Agregar script ArUco_Test.py para detección y seguimiento de marcadores ArUco en tiempo real
2026-06-13 Agregar impresión de finalización al script ArUco_Test.py
2026-06-13 Remove print statement from ArUco_Test.py
    Remove unnecessary print statement at the end of the file.
2026-06-13 Add new 3D models for chess pieces and gear adapter
    - Added 'Chess Pieces final-3.stl' to the 3D models directory.
    - Added 'Gear adapter-1.stl' to the 3D models directory.
    [Base del tablero-3.stl, Gear adapter-1.stl]
2026-06-23 Actualizar el README.md con una descripción detallada del proyecto, especificaciones tecnológicas y optimizaciones del sistema de visión.
2026-06-23 Eliminar sección de "Getting Started & Execution" del README.md
2026-06-23 Add modular chess engine node (Stockfish/UCI) with difficulty levels
    Introduces a ROS2-style modular package `magnus` whose engine node receives a
    board position (FEN) and returns the chosen move, with configurable difficulty.
    - magnus/core/messages.py: typed, dependency-free contracts (PositionRequest,
    MoveResponse) shared between nodes; JSON-serializable.
    - magnus/engine/difficulty.py: DifficultyLevel scale (BEGINNER..MAXIMUM) mapped
    to EngineConfig (skill level / Elo / search limits).
    - magnus/engine/backend.py: pluggable EngineBackend abstraction with a
    UCIEngineBackend (works with Stockfish or any UCI engine) and auto-detection
    of the engine binary.
    - magnus/engine/chess_engine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
2026-07-06 Implementar módulos de visión y brazo, config central, tests y demos
    Visión (magnus/vision/): detección ArUco con enclavamiento y 3 roles
    separados, homografía de esquinas, mapeo oficial ID→pieza (0-15 blancas,
    16-31 negras), construcción de FEN, GameTracker (deduce turno/enroque/al
    paso por inferencia contra jugadas legales), calibración de cámara e
    imágenes sintéticas para probar sin hardware.
    Brazo (magnus/arm/): ArmBackend ABC + FakeArmBackend + CyberPiBackend
    (stub con TODOs de protocolo), tabla de posiciones teach & playback
    (sin IK) y ArmNode que planifica y reproduce secuencias para jugadas
    simples, capturas, al paso, enroques y promociones.
    Además: magnus/config.py (c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
2026-08-09 Implementar backend CyberPi y pruebas de conexión del brazo MAGNUS
2026-08-13 Actualizar test_humo.py para mover los motores del brazo MAGNUS y mejorar la documentación de uso
2026-08-13 Aumentar ANGULO_PRUEBA a 30 grados para pruebas de movimiento más seguras
2026-08-14 Detección multi-instancia por tipo de pieza + tablero visual profesional
    El marcador ArUco ahora identifica el TIPO de pieza (todos los peones
    blancos comparten ID), igual que los marcadores físicos impresos, y el
    demo de visión muestra una representación 2D profesional del tablero.
    - piece_map/config: mapeo oficial por tipo — blancas 0=P 1=N 2=B 6=R 8=Q
    9=K, negras 12=p 15=n 16=b 18=r 21=q 23=k (IDs físicos reales)
    - aruco_detector: DetectionLatch multi-instancia — rastrea cada marcador
    por posición (asociación espacial auto-escalada + olvido configurable),
    así los 8 peones con el mismo ID se detectan a la vez
    - vision_node/synthetic: adaptados a detecciones en lista (IDs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
2026-08-14 Arreglar CI: conftest.py para que 'pytest tests/' importe magnus
    El workflow corre el binario pytest (no 'python -m pytest'), que no añade
    la raíz del repo a sys.path. El único arreglo era un sys.path.insert
    dentro de test_chess_engine.py, que solo beneficiaba a los módulos
    colectados después de él en orden alfabético — por eso test_arm_node,
    test_aruco_detector, test_board_pose y test_board_render fallaban con
    ModuleNotFoundError en CI.
    tests/conftest.py añade la raíz del repo a sys.path antes de colectar
    cualquier módulo (determinista, independiente del orden y del modo de
    invocación); el hack local de test_chess_engine.py se elimina.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
    [test_chess_engine.py]
2026-08-15 Arreglar la pose del tablero: esquinas cruzadas, tapadas y marcadores fuera
    Con los marcadores de esquina colocados en "orden de lectura" (40 y 41 arriba,
    42 y 43 abajo) en vez de recorriendo el borde, el cuadrilátero se cruzaba y
    cv2.getPerspectiveTransform devolvía una homografía degenerada: las 32 piezas
    caían "fuera del tablero" (y pixel_to_square llegaba a recibir NaN), así que el
    tablero digital salía vacío y no se generaba ninguna FEN pese a detectarse
    correctamente los 36 marcadores.
    - board_pose: deduce_corner_layout() deduce de la geometría qué esquina ocupa
    cada marcador (orden cíclico en la imagen + voto mayoritario de los IDs), así
    que ninguna de las 24 colocacio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
    [generate_aruco_markers.py, run_vision_demo.py, test_aruco_detector.py]
2026-08-15 Cámara: esperar al primer frame y tolerar frames perdidos
    Con una cámara virtual (Iriun, EpocCam, OBS) el dispositivo abre antes de estar
    transmitiendo, así que isOpened() daba True y el demo reventaba en la primera
    lectura con "No se pudo leer un frame de la cámara". En macOS pasa lo mismo
    cuando el permiso de cámara aún no está concedido a la app — de ahí que
    reiniciar VS Code lo arreglara a veces.
    - OpenCVCameraBackend.open() espera hasta warmup_s (5 s por defecto) al primer
    frame válido y, si no llega, explica las causas típicas: permisos de macOS,
    app de la cámara virtual sin transmitir, dispositivo ocupado o índice
    equivocado. Libera la cámara antes de fallar.
    - r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
    [run_vision_demo.py, test_vision_node.py]
2026-08-15 Rediseñar el icono del caballo para que parezca un caballo
    El glifo vectorial anterior se leía como una cabeza de gato: hocico corto y
    romo, orejas mal colocadas y el cuerpo como un bulto sin cuello.
    Nueva silueta de cabeza de caballo de perfil: hocico largo con ollar y boca,
    quijada marcada, ojo, oreja separada de la frente por una muesca, crin por
    detrás y cuello arqueado sobre una peana, en el mismo estilo (relleno +
    contorno) que el resto de las piezas. Se lee bien a 66 px de casilla.
    Claude-Session: https://claude.ai/code/session_01M2Hr2X9RkWvqxxXY42dbao
2026-08-15 Añadir voz: el robot narra sus jugadas y comenta la partida
    Nuevo módulo magnus/voice/, siguiendo el patrón de engine y arm (backend ABC +
    Fake para tests). El robot dice qué mueve y de dónde a dónde, y comenta la
    calidad de las jugadas del rival.
    Motor de voz:
    - PiperBackend (neuronal local) como principal: offline, gratis y con el mismo
    código en el Mac y en la Raspberry Pi, así que sobrevive la migración.
    - MacSayBackend como respaldo sin instalación, FakeSpeechBackend para tests.
    - default_backend() elige el disponible y, si no hay ninguno, devuelve el falso:
    quedarse sin voz nunca interrumpe una partida. Un fallo de audio se registra y
    el juego sigue en silencio.
    Qué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
2026-08-15 Voz masculina por defecto en macOS y audición de voces del sistema
    MAGNUS habla en masculino, pero la voz de `say` por defecto era Paulina
    (femenina). Ahora es Juan (es_MX), y si no está instalada el backend busca otra
    voz masculina en español —o cualquiera en español— en vez de fallar: un nombre
    de voz mal escrito no puede dejar mudo al robot en mitad de una demostración.
    - list_system_voices() lee `say -v '?'` y parsea también los nombres modernos
    con paréntesis ("Eddy (Spanish (Mexico))"), donde el idioma es el último
    campo y el nombre todo lo anterior.
    - MacSayBackend resuelve la voz al construirse y avisa por log de la sustituta.
    - examples/audition_voices.py ahora audi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
2026-08-15 Voz de Piper: máxima naturalidad, sin efectos y con calidad alta por defecto
    El sonido "bajo el agua" no venía de ningún efecto —el código no aplica
    filtros, ni cambios de tono, ni resampleo— sino del nivel de calidad del
    modelo: es_ES-davefx-medium es `medium`, y los niveles bajos de Piper suenan
    apagados. Cambios para que suene lo más humana y clara posible:
    - VOICE_LENGTH_SCALE pasa de 0.95 a 1.0: la cadencia exacta del modelo. El 0.95
    buscaba carácter de robot, pero ahora prima la naturalidad.
    - VOICE_PIPER_MODEL pasa a es_MX-claude-high (masculina, calidad `high`).
    - model_quality() deduce el nivel del nombre; el script de audición marca la
    calidad de cada candidata, las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
2026-08-15 Usar python3 en toda la documentación y en los mensajes de ayuda
    En macOS no existe el comando `python` (solo `python3`), así que todos los
    ejemplos de la documentación fallaban con "zsh: command not found: python".
    - README, CLAUDE.md y los docstrings de examples/ pasan a `python3 …`.
    - Los mensajes que imprime el código ya no sugieren un `python` genérico: usan
    sys.executable, así que la orden que se muestra es copiable y apunta al
    intérprete con el que realmente se está ejecutando. Aplica al modelo de voz
    no encontrado, al paquete de Piper ausente y al aviso de "sin voz".
    - Nota en el README sobre el desajuste de intérpretes (`pip install` en un
    Python y ejecutar con o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
2026-08-15 Ignorar los modelos de voz en git y fijar la voz elegida
    Los .onnx de Piper pesan entre 60 y 110 MB y GitHub rechaza el push en cuanto
    uno pasa de 100 MB (GH001: Large files detected), así que descargar varias
    voces para audicionarlas dejaba el repo imposible de sincronizar.
    - .gitignore: voices/, *.onnx, *.onnx.json, *.wav y aruco_markers/. Son
    artefactos regenerables (se descargan o se generan con un script), no fuente.
    - VOICE_PIPER_MODEL pasa a es_ES-davefx-medium, la voz elegida tras la
    audición.
    - README: aviso del límite de tamaño de GitHub y cómo sacar los modelos del
    índice si ya se commitearon.
    Claude-Session: http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
2026-08-15 No exigir calidad `high` en la voz configurada
    El test anterior daba por hecho que la voz por defecto debía ser un modelo
    `high`, pero cuál suena mejor es una decisión de oído del usuario y la elegida
    tras la audición fue es_ES-davefx-medium. Ahora solo se comprueba que el
    nombre lleve un sufijo de calidad reconocible, que es lo que de verdad protege
    de una errata en config.py.
    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
    [test_voice.py]
2026-08-15 No dar por hecha la Raspberry Pi en la documentación de la voz
    La Pi queda como posible continuación del proyecto, no como plataforma de esta
    feria: Piper se justifica por sí solo en el Mac (offline, sin depender del wifi
    del recinto). Se aprovecha para recordar en ambos sitios que los modelos pesan
    60-110 MB y no van en git.
    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
2026-08-15 Ampliar el repertorio de voz y avisar de las jugadas ilegales
    El robot hablaba poco y solo de sus propias jugadas. Ahora acompaña la partida
    de principio a fin y, sobre todo, dice al rival cuándo se ha equivocado al
    mover — que era lo que faltaba para que la demostración se explique sola.
    Aviso de tablero (lo nuevo importante):
    - commentary.diagnose_placement() compara el placement esperado con el
    detectado y distingue tres casos en vez de un genérico "no entiendo": pieza
    levantada (falta una y no hay ninguna nueva), jugada ilegal (una pieza cambió
    de casilla) y posición irreconocible (mano encima, piezas caídas).
    - El aviso NO se repite mientras el problema siga igual: duran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
    [run_vision_demo.py, test_voice.py]
2026-08-15 Reducir el tiempo de espera para el recordatorio de inactividad a 30 segundos
2026-08-15 Callar la narración de la jugada del rival y los avisos de tablero
    Dos comportamientos de voz que molestaban más de lo que aportaban en una
    partida real pasan a estar desactivados por defecto:
    - VOICE_ANNOUNCE_HUMAN_MOVES: repetir en voz alta la jugada que el rival
    acaba de hacer delante del robot es redundante. Con el flag apagado se
    mantienen las reacciones a capturas y jaques, que sí aportan.
    - VOICE_WARN_BOARD_PROBLEMS (nuevo): con poca luz la detección de algunas
    piezas parpadea — se detectan, se pierden un par de segundos y vuelven —
    y cada parpadeo se leía como una pieza retirada del tablero, así que el
    robot avisaba de faltas inexistentes.
    No se borra nada: dia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
2026-08-16 Recuperar el aviso de jugada ilegal, callando los otros dos
    VOICE_WARN_BOARD_PROBLEMS pasa de ser un interruptor todo-o-nada a la lista de
    problemas que se cantan, y por defecto contiene solo la jugada ilegal.
    El motivo por el que se apagaron todos era el parpadeo de la detección con
    poca luz, pero afecta de forma muy distinta a cada aviso: "pieza levantada" y
    "posición irreconocible" se disparan cuando una pieza DESAPARECE, que es
    justo lo que produce el parpadeo, mientras que "jugada ilegal" exige que la
    pieza reaparezca en OTRA casilla — algo que el parpadeo no hace. Así que ese
    aviso es fiable incluso con mala luz, y encima es el único que le dice al
    rival algo que no sabe ya.
    L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
    [run_vision_demo.py, test_voice.py]
2026-08-16 Eliminar el decimal en el tiempo de espera para el recordatorio de inactividad
2026-08-16 Aumentar el tiempo de espera para el recordatorio de inactividad a 45 segundos
2026-09-09 Añadir play.py: la aplicación de juego con panel de control web
    Nuevo paquete magnus/app/ que une visión, engine, voz y brazo en una sola
    aplicación lista para jugar, con la interfaz en el navegador (servidor HTTP
    de la librería estándar + HTML/CSS/JS sin dependencias):
    - session.py: GameSession, EngineWorker (dificultad en caliente) y
    SyntheticCamera, extraídos de examples/run_vision_demo.py y compartidos
    con él
    - settings.py: ajustes persistentes en magnus_settings.json
    - arm_bridge.py: ArmSupervisor con modos apagado / simulado / CyberPi,
    ejecución en hilo con progreso por paso y parada; el modo real solo se
    habilita con positions.json completo
    - controller.py: bucle de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
2026-09-09 Añadir archivo de configuración magnus_settings.json con parámetros iniciales
2026-09-12 Brazo: referenciado automático contra topes y movimientos verificados
    Dos problemas del brazo real, ambos del lado del control de motores.
    1. Los motores apenas se movían al pedirles 30°. El control interno del
    motor encoder es de velocidad: a 25 RPM el PWM no vence el peso del
    brazo, el eje se queda a medio camino y EM_turn devuelve igual. El
    cliente sube a 60 RPM, verifica el ángulo alcanzado y reintenta hasta
    entrar en tolerancia, y contesta ERR si se queda fuera de margen.
    MOVE ahora devuelve los ángulos logrados y el host avisa en el log.
    2. Había que fijar el cero a mano en cada partida. Los encoders son
    incrementales: sin referencia física, positions.json ap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
    [cyberpi_arm_client.py, test_app_arm_bridge.py, test_app_controller.py]
2026-09-12 Quitar las credenciales Wi-Fi del cliente de la CyberPi
    El repositorio es público y el cliente versionado llevaba el SSID y la
    clave del hotspot en texto plano. Se sustituyen por marcadores: la clave
    real se escribe en mBlock justo antes de subir el programa a la placa y
    no vuelve nunca al repositorio.
    La clave estuvo en el commit anterior de esta rama, que ya se empujó, así
    que conviene cambiarla en el teléfono.
    Claude-Session: https://claude.ai/code/session_01MV3vxfZPTttSfWvmhoAX5D
2026-09-12 Brazo: el recorrido util va del lado contrario al tope
    Tras referenciar, el cero queda junto al tope, asi que todos los angulos
    validos de un eje estan del lado opuesto a su sentido de busqueda. El codo
    busca su tope en positivo, asi que solo admite angulos negativos: mandarle
    +30 lo empujaba contra el tope.
    - Los limites de cada eje se derivan del sentido de referenciado con
    _limits_from_home() en vez de escribirse a mano, asi no pueden
    contradecirlo. Un movimiento hacia el tope se rechaza con ERR con un
    mensaje que explica la regla, en vez de estrellar el brazo.
    - El cero se declara HOME_ZERO_OFFSET_DEG separado del tope, para que
    "ir a 0" no deje el motor forzando la transmision.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
2026-09-13 Cliente CyberPi: no colgarse esperando el Wi-Fi
    conectar_wifi() giraba en un bucle sin salida hasta conectar. Si el
    hotspot no estaba encendido, la placa quedaba atascada ahi, y una placa
    atascada es una placa a la que cuesta subirle un programa nuevo desde
    mBlock (la subida se queda en 1 %).
    Ahora la conexion tiene limite de tiempo (WIFI_TIMEOUT_S), avisa en
    pantalla y se reintenta desde el bucle principal, que ademas para los
    motores en cada vuelta para que un fallo de red nunca deje un motor
    empujando.
    CLAUDE.md documenta que una subida colgada en 1 % es de transporte, no
    de codigo, con los pasos para desbloquearla.
    Claude-Session: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
2026-09-17 Actualizar CLAUDE.md: mejorar formato y añadir reglas de seguridad del proyecto
2026-09-17 CLAUDE.md: prohibir check-ins automáticos recurrentes en la sesión
    Un check-in horario del PR encadenado con send_later agotó los tokens
    semanales. Ninguna sesión debe programar recordatorios recurrentes ni
    re-armarlos sin que el usuario lo pida explícitamente.
    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
2026-09-20 Add tests for arm position recording and implement position recording script
    - Introduced `record_arm_positions.py` to capture manual arm positions and output them in JSON format for `positions.json`.
    - Added `test_record_arm_positions.py` to validate the functionality of the recording script using a fake backend.
    - Enhanced existing tests in `test_positions_report.py` and `test_positions_table.py` to cover new position formats and legacy compatibility.
    - Documented the process for capturing arm positions manually and ensured proper error handling in the recording script.
    [cyberpi_arm_client.py, generate_positions_template.py, record_arm_positions.py, test_app_arm_bridge.py, test_arm_node.py]
2026-09-20 Agregar posiciones de brazo con ángulos de hombro y codo
2026-09-20 Brazo: precision de los motores y hombro antes que codo
    El brazo se quedaba corto (c7 -> c5: el hombro paraba en 35 de los 50
    pedidos) y movia el codo antes que el hombro.
    Causa de la imprecision: el control interno del motor encoder es de
    VELOCIDAD, no de par, y la correccion BAJABA la velocidad al acercarse al
    objetivo — justo al reves de lo que hace falta. Encima el criterio para
    detectar el problema era "el eje no se ha movido nada", y el eje si se
    movia: cubria un cuarto del giro pedido. Nunca saltaba.
    Ahora cada MOVE tiene dos fases:
    1. _drive_turns: EM_turn como hasta ahora, pero una pasada que cubre
    menos de MOVE_PROGRESS_RATIO de lo pedido sube la velocidad hasta
    MO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
    [cyberpi_arm_client.py]
2026-09-20 Retirar el brazo del tablero y grabar la tabla con los motores puestos
    Tres cosas del ultimo ensayo con el brazo real.
    1) RETIRADA (zona `park`)
    El brazo se quedaba plantado donde terminaba la jugada: le estorba al rival
    y le tapa el tablero a la camara, que es como la vision se entera de la
    jugada siguiente. ArmNode.plan() anade ahora un ultimo paso a la pose de
    reposo en TODA jugada, y la interfaz lo llama "Retirarse del tablero".
    `park` es OPCIONAL a proposito. Si fuese obligatoria, las tablas ya
    calibradas pasarian a estar incompletas y la interfaz dejaria de permitir
    el brazo real hasta recalibrar. Sin ella se juega igual y queda un aviso.
    2) SE QUEDA CORTO SIN DAR ERROR
    Eso ya no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
    [cyberpi_arm_client.py, record_arm_positions.py, test_app_arm_bridge.py, test_arm_node.py]
2026-09-20 Jog: no perder el ajuste, y escribir la tabla sin copiar a mano
    Del primer uso real del modo jog salieron dos fallos y un dato.
    1) `q` TIRABA EL TRABAJO
    Salir con `q` descartaba el ajuste de la posicion en curso sin avisar, que
    es justo lo que mas cuesta conseguir: la sesion de `park` termino sin
    grabar nada. Ahora pregunta antes, y Enter la graba y sale.
    2) UN ANGULO FUERA DE LIMITES TIRABA LA FLEXION
    Tras rechazar un ajuste, el objetivo se reponia con la lectura del ENCODER.
    Pero la orden y el encoder no son lo mismo, y esa diferencia es justo la
    flexion que este modo existe para capturar: reponer desde el encoder la
    tiraba, y ademas en el eje que no tenia nada que ver (un `c+50` inval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
2026-09-20 Agregar nueva posición "park" y crear respaldo de configuraciones de brazo
2026-09-21 Desactivar la opción de inversión de vista en la configuración del robot
2026-09-26 Garra que levanta la pieza y brazo mas preciso
    Garra (S1): tres posiciones medidas en el brazo real. GRIPPER 1 baja el
    iman (0), agarra y LEVANTA la pieza (250) antes de responder ACK, asi el
    MOVE siguiente ya no la arrastra por el tablero llevandose a las vecinas.
    GRIPPER 0 la suelta (300).
    Precision del cliente:
    - Entrada unidireccional activada (BACKLASH_DEG = 3): el juego de la
    reductora no lo ve el encoder, y la tabla grabada a pasos pequenos y la
    partida con giros largos llegaban cada una por su lado. El giro de
    "pasarse" usa _drive_turns para no quedarse del lado malo.
    - MOVE_SAG_DEG 2 -> 1 y hasta dos rondas de repaso: con 2 grados se daba
    por bueno justo el "par de grados"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
    [cyberpi_arm_client.py, record_arm_positions.py, test_app_controller.py, test_cyberpi_arm_client.py, test_record_arm_positions.py]
2026-09-26 Actualizar ángulos de agarre y liberación del gripper para mejorar la funcionalidad
2026-09-26 Eliminar comentarios redundantes y ajustar ángulos de la garra para mayor claridad
2026-09-26 Brazo: que no se quede buscando la casilla hasta el timeout
    El brazo oscilaba alrededor del destino hasta que el host cortaba a los
    20 s. Tres causas y sus arreglos en el cliente:
    - El repaso de un eje que habia cedido (o se habia pasado) repetia la
    compensacion de juego: retrocedia BACKLASH_DEG, volvia a pasarse y
    vuelta a empezar. Ahora el repaso va directo (approach=False).
    - MOVE_SAG_DEG estaba en 1 grado, igual que TOLERANCE_DEG: cualquier
    temblor del encoder disparaba otro repaso. Sube a 1.5.
    - Los impulsos finales podian cruzar el objetivo 4 veces y dar 30
    impulsos. Bajan a 2 cruces y 20 impulsos.
    Ademas, un MOVE deja de afinar a los MOVE_BUDGET_S (15 s) y responde
    con lo qu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
    [cyberpi_arm_client.py, test_cyberpi_arm_client.py]
2026-09-26 Brazo: arreglar el desborde de pila; camara: que no se quede en negro
    CyberPi: "ERR maximum recursion depth exceeded" antes de mover nada. El
    programa subido tiene muy poca pila y la funcion _move_all_timed del
    cambio anterior anadio un nivel de llamadas de mas justo encima de
    EM_turn. Se quita, y _drive_turns llama a EM_turn directamente (un nivel
    menos que el cliente que ya funcionaba). Un test mide la profundidad de
    llamadas bajo handle() y falla si vuelve a crecer.
    Interfaz: la imagen de la camara se quedaba a veces en negro aunque la
    vision funcionara. El MJPEG ocupa una conexion fija; si se atasca, o el
    navegador la deja en cola por el limite de conexiones (con el SSE y
    varias pestana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
    [cyberpi_arm_client.py, test_app_server.py, test_cyberpi_arm_client.py]
2026-09-27 Brazo: mover el hombro el ultimo
    "ERR hombro no mantuvo 59.0 (quedo en 52)": el hombro llegaba, el codo
    giraba 215 grados y se llevaba el hombro 7 grados atras, sin que el
    repaso pudiera devolverlo con el brazo desplegado. Ahora el MOVE mueve
    el codo primero y el hombro al final (MOVE_SHOULDER_FIRST = False): el
    eje que peor se sostiene va el ultimo y ya nada lo desplaza despues.
    Tests: el caso real falla con el orden viejo y pasa con el nuevo; los
    tests de repaso que asumian el hombro primero lo fijan explicitamente, y
    el de profundidad de pila se comprueba en los dos ordenes.
    Claude-Session: https://claude.ai/code/session_01AuapSpMm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
2026-09-27 Brazo: el hombro entra a favor de su carga y se sostiene entre impulsos
    "ERR hombro no mantuvo 52.0 (quedo en 47)" con el hombro ya moviendose
    el ultimo: el hombro cae solo hacia negativo sin que nada mas se mueva.
    - Sentido de entrada por eje: el hombro entra BAJANDO
    (SHOULDER_APPROACH_SIGN = -1), a favor de la carga, asi la holgura de
    la reductora ya esta apoyada de ese lado y no cede al parar. El codo
    sigue entrando subiendo.
    - _creep_to vuelve a poner la retencion en las pausas entre impulsos:
    sin ella un eje cargado perdia en cada pausa lo ganado en el impulso.
    - CREEP_POWER_MAX 40 -> 55.
    - Garra: levantar 110, soltar 170 (medidos en el brazo real).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
2026-09-27 Brazo: agregar opción --home-each para referenciar antes de cada destino en modo JOG; añadir pruebas correspondientes
2026-09-27 Agregar función _hand_capture para grabar posiciones manualmente con opción --home-each; añadir pruebas correspondientes
2026-09-27 Agregar lógica para repetir la casilla anterior y confirmar lecturas en cero en _hand_capture; añadir pruebas correspondientes.
2026-09-28 Actualizar posiciones del brazo en positions.json; ajustar valores de shoulder y elbow para mejorar la precisión.
2026-10-11 Agregar lógica para reintentar movimientos rechazados por la placa; implementar manejo de errores y pruebas correspondientes.
2026-10-11 Actualizar lógica del brazo para que ejecute automáticamente cada jugada, manteniendo la opción de pausa tras un fallo; ajustar pruebas correspondientes.
2026-10-11 feat: enhance arm control and placement logic
    - Introduced `release_index` function to determine the last "grip_off" action in the arm's movement plan.
    - Added `placement_during` function to update the board placement dynamically as the arm moves pieces, allowing for real-time visual feedback.
    - Modified `ArmSupervisor` to track the current movement plan and steps completed, enabling better integration with the controller.
    - Updated `MagnusController` to commit moves immediately upon piece release, improving responsiveness and user experience.
    - Enhanced arm movement logic to include tolerance for off-board movements, allowing for more flexible positioning without compromising accuracy.
    - Ad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
2026-10-11 fix: corregir lógica para determinar casillas claras en el tablero
2026-10-11 feat: mejorar niveles de dificultad y lógica de selección de movimientos
2026-10-20 docs: actualizar el README al estado actual del proyecto
    - 10 niveles de dificultad (los cuatro más bajos con errores a propósito)
    - Brazo: puertos, sin reductores, garra de tres posiciones, TCP sobre Wi-Fi,
    referenciado HOME y signos de los ejes
    - Grabación de la tabla con --jog/--write, zona park y control de los ejes
    - Ejecución automática del brazo: la PARADA ya no apaga el modo
    - Hoja de ruta, dependencias (piper-tts), estructura (voice/, app/) y tests
2026-10-20 docs: actualizar CLAUDE.md al estado real del brazo y del engine
    - positions.json ya existe (grabado con el brazo real, 67 claves) y no se
    edita a mano
    - Formato de una posición por casilla; approach/engage es legado
    - Secuencia de jugada con levantar la pieza y retirarse a park
    - 10 niveles de dificultad, pendientes del brazo y número de tests
    - Mismo ajuste en el docstring de positions_table.py
